Phong28Ng/drone-mini-xiao-esp32s3/docs/diagrams/1-so-do-khoi.png

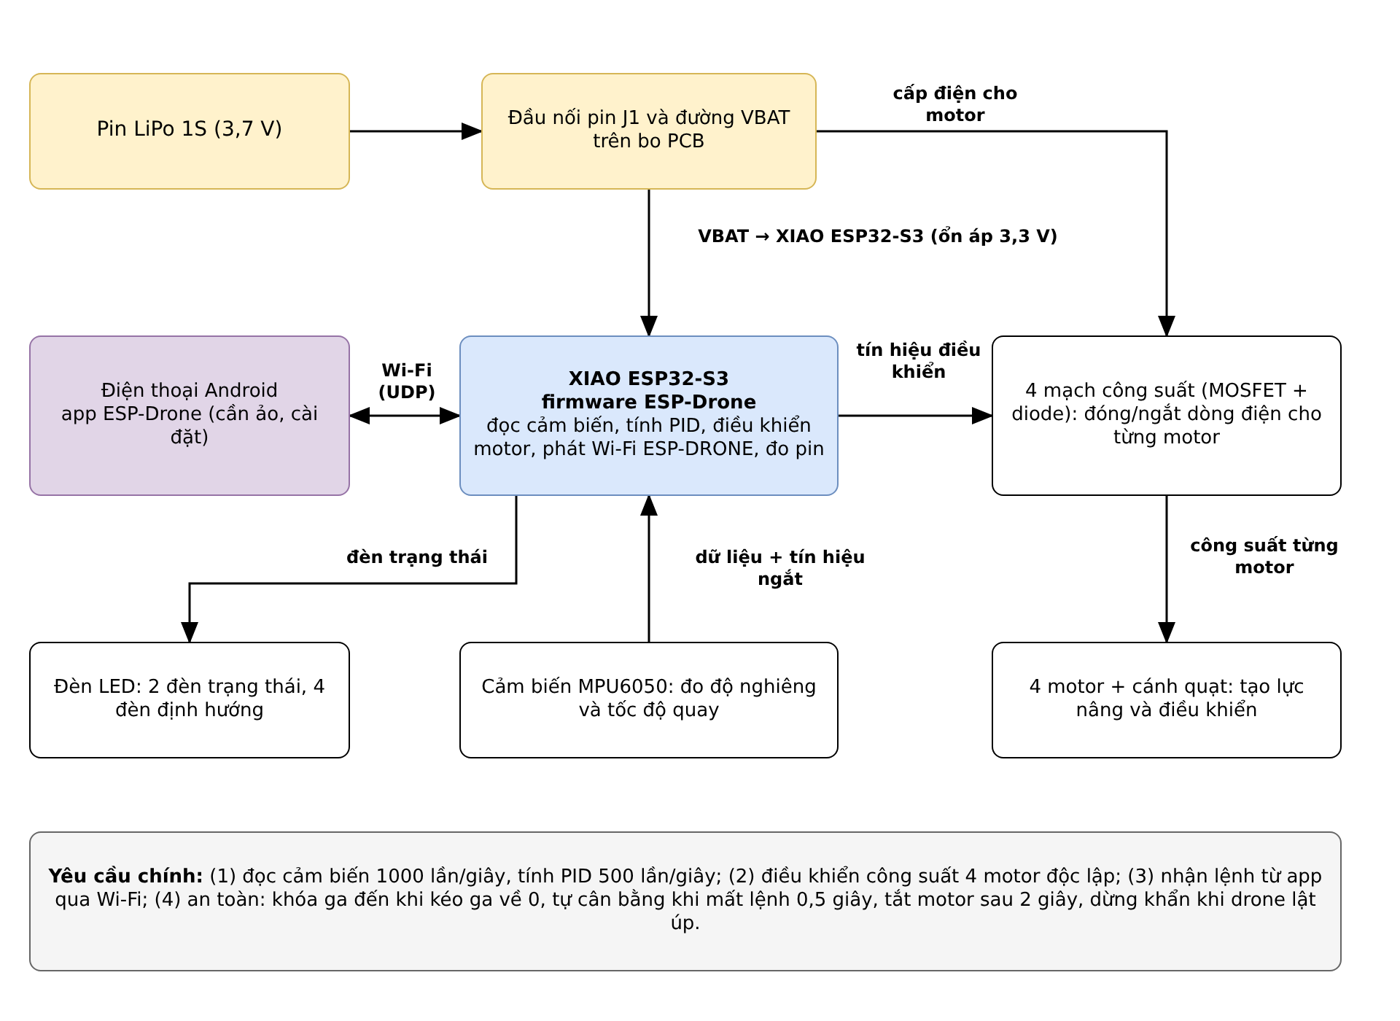
docs/diagrams/1-so-do-khoi.png
