Phong28Ng/drone-mini-xiao-esp32s3/docs/diagrams/2-so-do-dau-noi.png

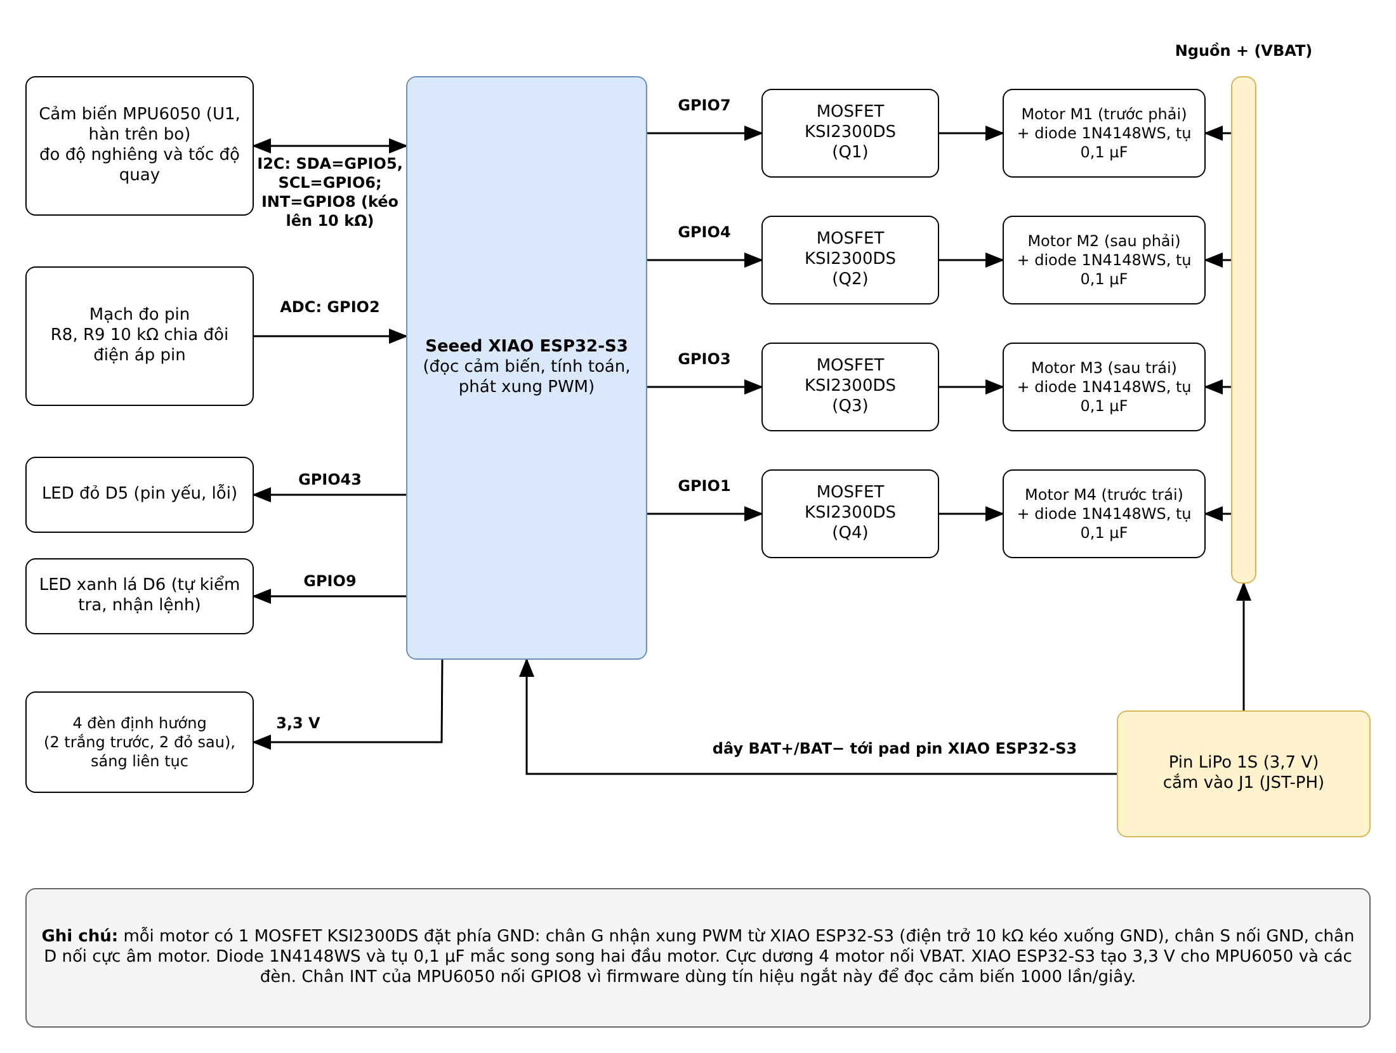
docs/diagrams/2-so-do-dau-noi.png
