Phong28Ng/drone-mini-xiao-esp32s3/docs/diagrams/3-luu-do-chuong-trinh-chinh.png

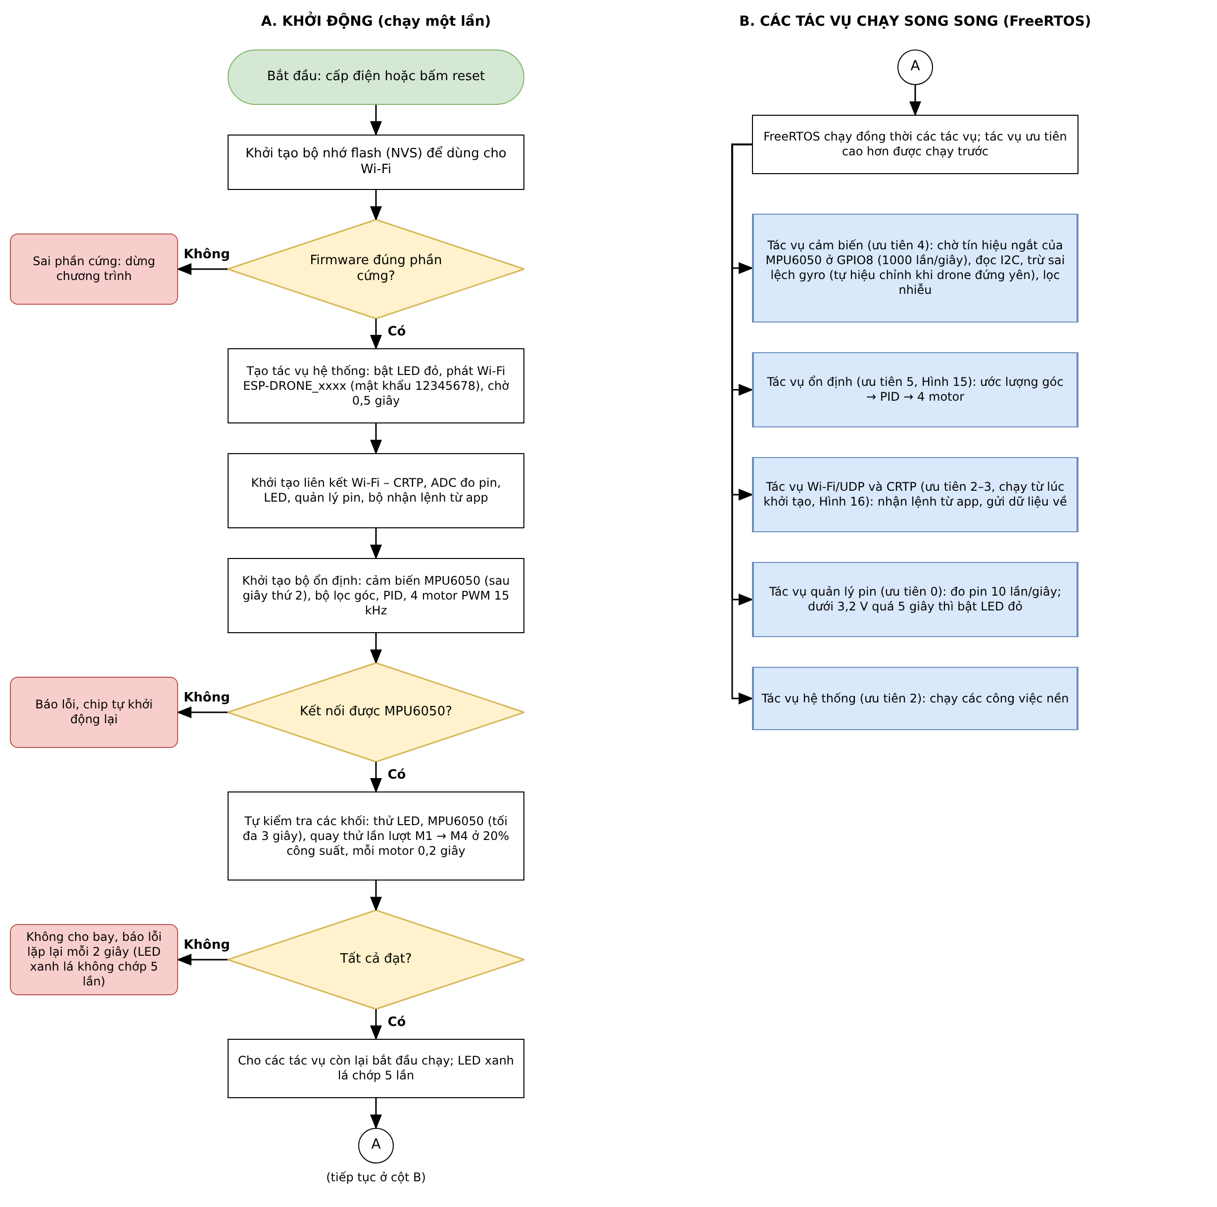
docs/diagrams/3-luu-do-chuong-trinh-chinh.png
