Phong28Ng/drone-mini-xiao-esp32s3/docs/diagrams/4-vong-on-dinh.png

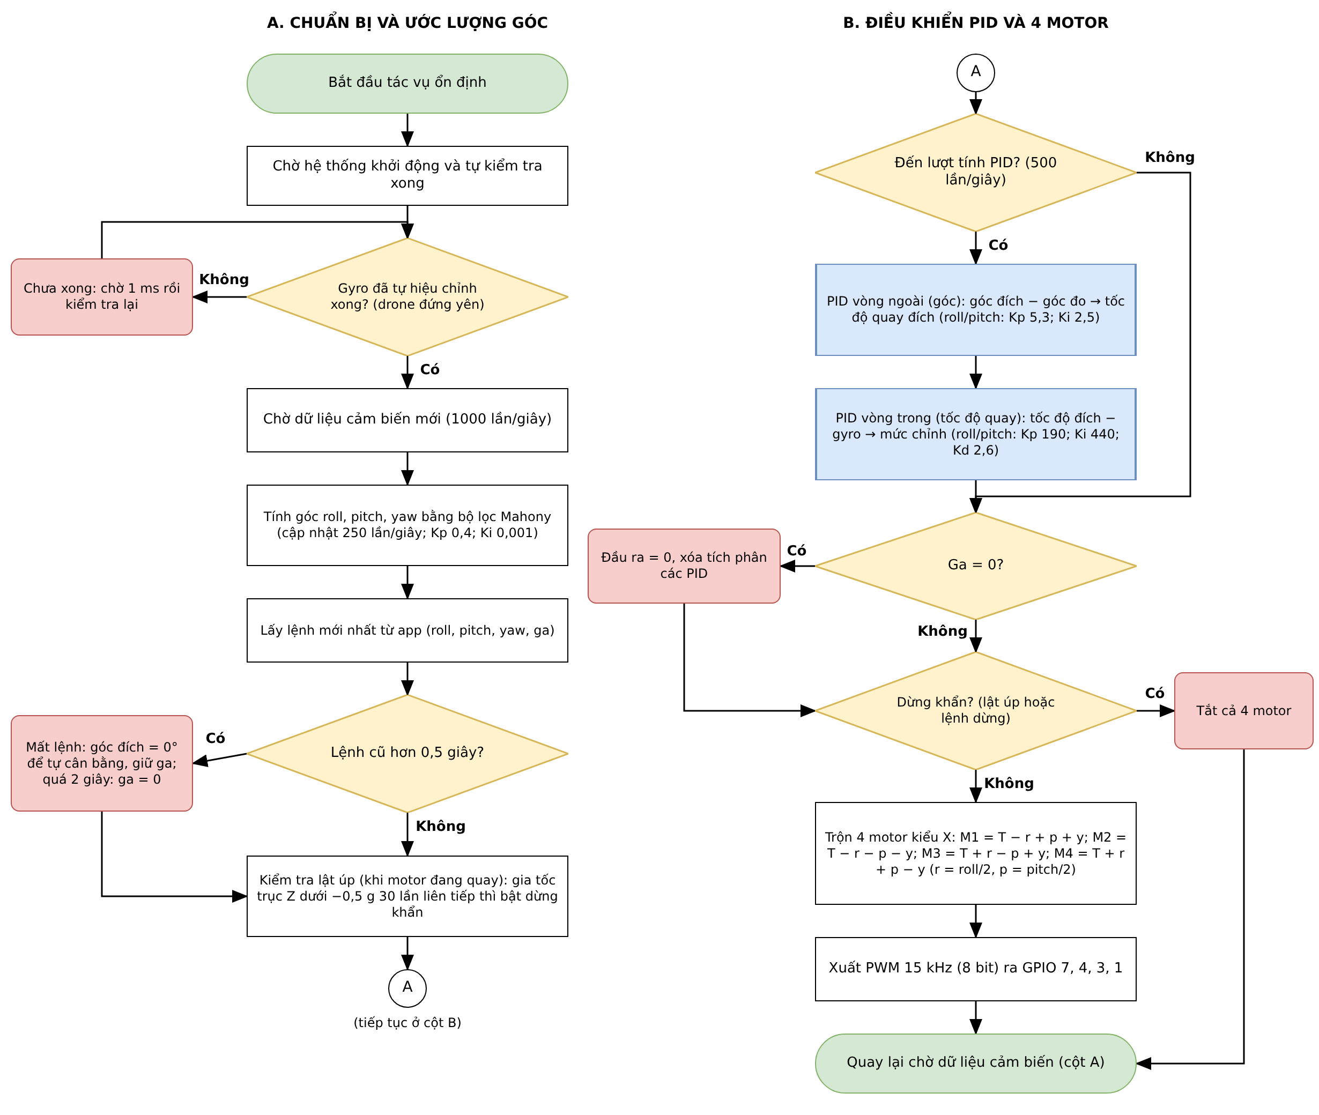
docs/diagrams/4-vong-on-dinh.png
