Phong28Ng/drone-mini-xiao-esp32s3/docs/diagrams/5-giao-tiep-app-drone.png

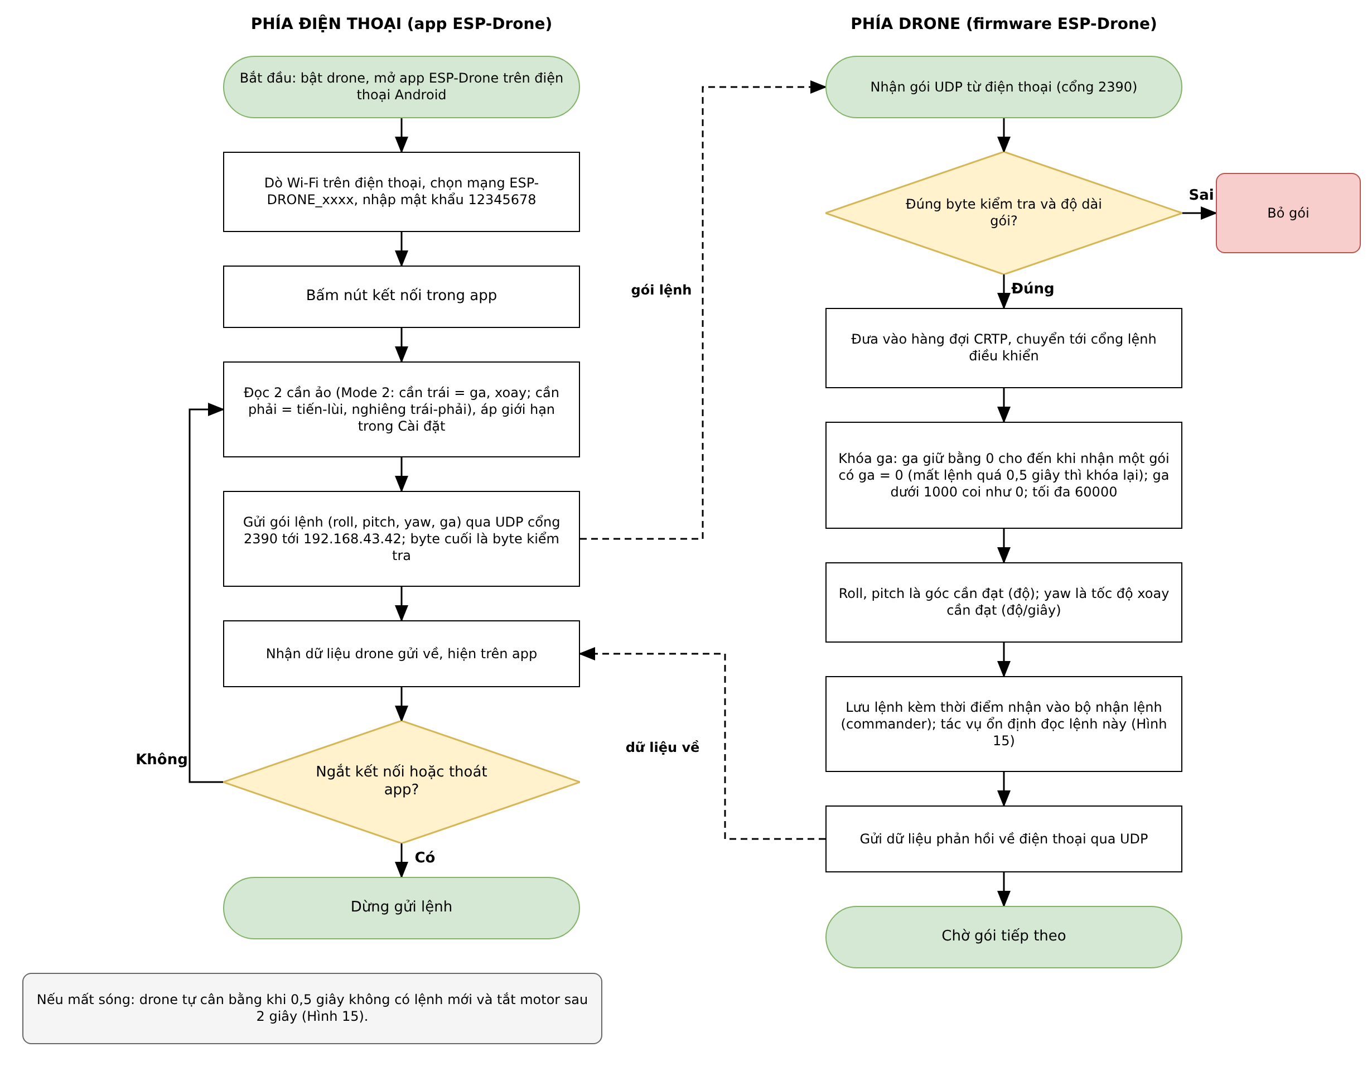
docs/diagrams/5-giao-tiep-app-drone.png
