Phong28Ng/drone-mini-xiao-esp32s3/docs/images/bo-mach-sau-gia-cong.png

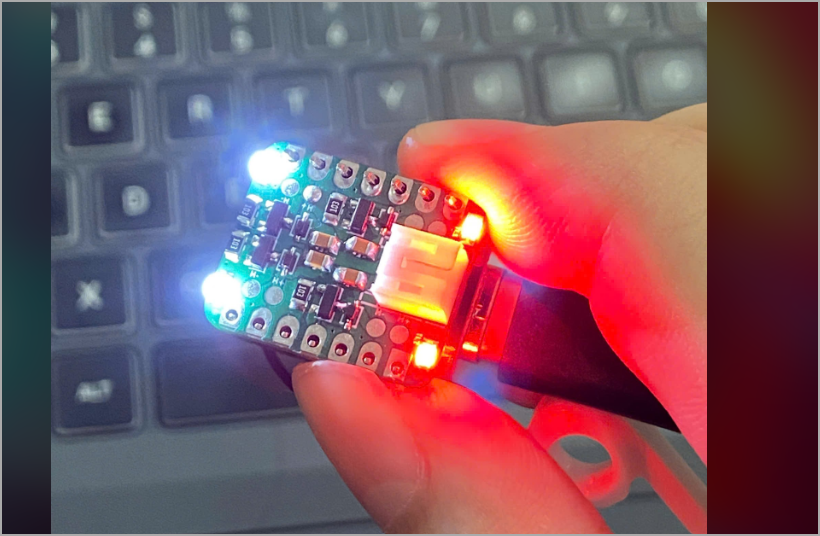
docs/images/bo-mach-sau-gia-cong.png
