Phong28Ng/drone-mini-xiao-esp32s3/docs/images/xiao-esp32-s3-hong-chan.png

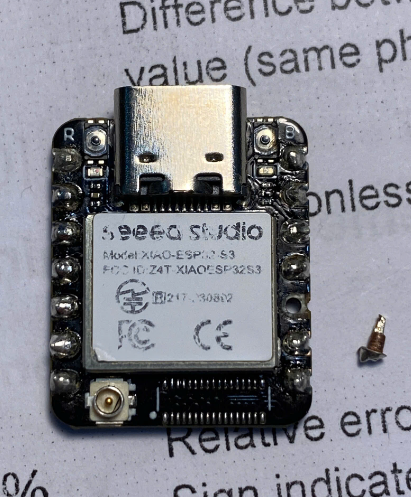
docs/images/xiao-esp32-s3-hong-chan.png
