Phong28Ng/drone-mini-xiao-esp32s3/frame/khung-3d-solidworks.png

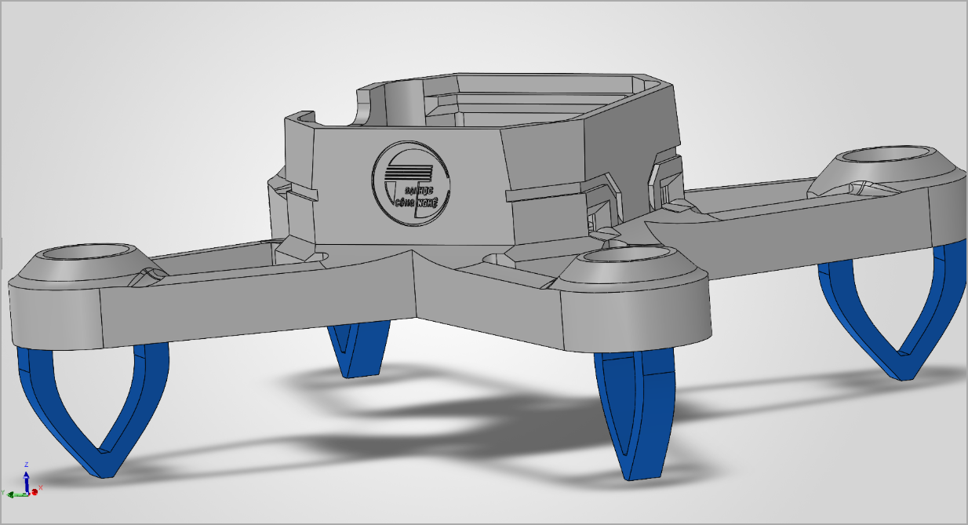
frame/khung-3d-solidworks.png
