Phong28Ng/drone-mini-xiao-esp32s3/hardware/BOM.xlsx

Ký hiệu tham chiếu | Số lượng | Giá trị / mô tả | Dấu chân PCB (Footprint) | Mã nhà sản xuất (MPN) | Công nghệ lắp ráp
R10, R11 | 2 | 200 | 0805 (2012 metric) | 0805W8F2000T5E | SMT
D1, D2, D3, D4 | 4 | 1N4148WS | SOD-323 | 1N4148WS-7-F | SMT
C6, C7 | 2 | 0.01uF | 0805 (2012 metric) | CC0805KRX7R9BB103 | SMT
C1, C2, C3, C4, C5, C8 | 6 | 0.1uF | 0805 (2012 metric) | CL21B104KBCNNNC | SMT
R12, R13 | 2 | 100 | 0805 (2012 metric) | CRCW0805100RFKEA | SMT
R1, R2, R3, R4, R5, R6, R7, R8, R9 | 9 | 10k | 0805 (2012 metric) | FRC0805F1002TS | SMT
Q1, Q2, Q3, Q4 | 4 | KSI2300DS | SOT-23 | KSI2300DS-T1-GE3 | SMT
U1 | 1 | MPU-6050 | QFN-24 4x4mm P0.5mm | MPU-6050 | SMT
D6 | 1 | Xanh lá | 0805 (2012 metric) | ORH-G35A | SMT
R14, R15 | 2 | 150 | 0805 (2012 metric) | RMS10FT1500 | SMT
J1 | 1 | JST-PH 1S LiPo | JST-PH 2pin P2.00mm right-angle THT | S2B-PH-K-S(LF)(SN) | THT
D5, TL1, TL2 | 3 | Đỏ | 0805 (2012 metric) | TZ-P2-0805RTCS2-0.8T | SMT
HL1, HL2 | 2 | Trắng | 0805 (2012 metric) | TZ-P2-0805WYCS2-0.8T | SMT
Tổng cộng | 39
