Phong28Ng/drone-mini-xiao-esp32s3/hardware/kicad/3dmodels/SOT-23.step

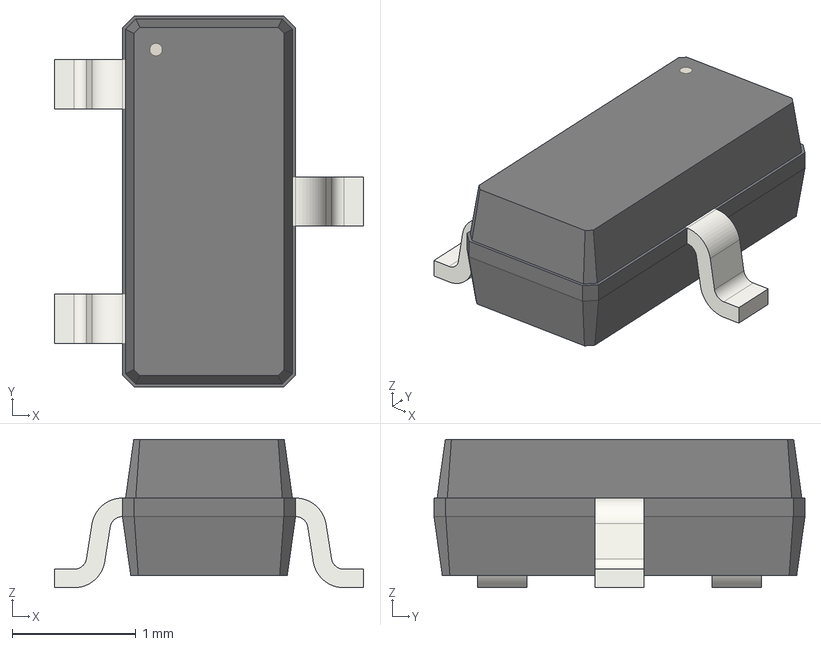
[picture p10: CAD file, 2026-11-12]
hardware/kicad/3dmodels/SOT-23.step
2.50 x 3.00 x 1.20 mm
