Phong28Ng/drone-mini-xiao-esp32s3/hardware/kicad/3dmodels/ESP-FLY-header-1x07-đã-cắt-ngắn.step

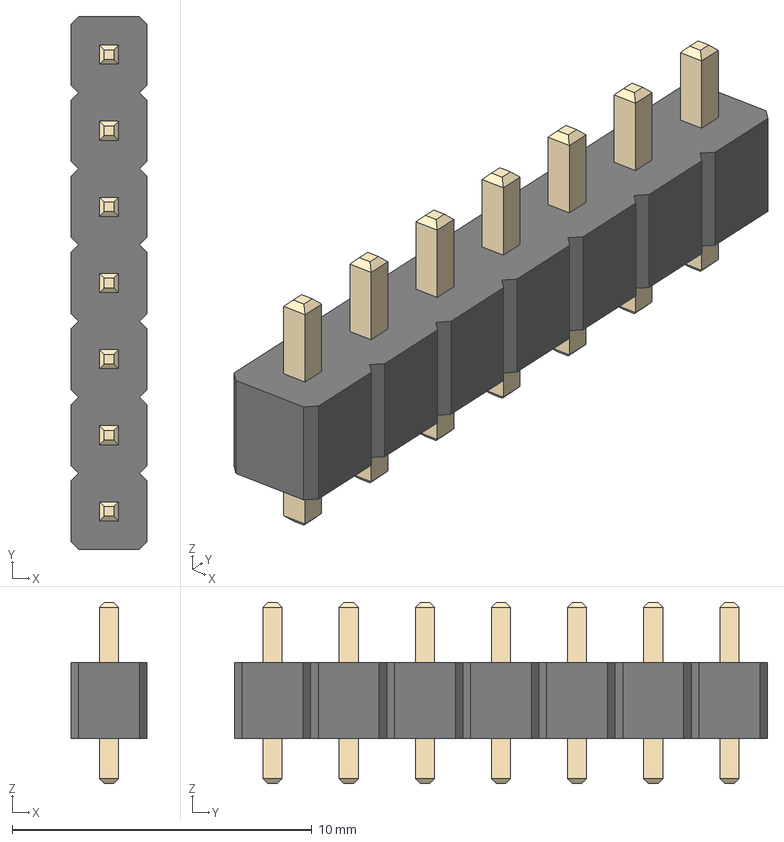
[picture p11: CAD file, 2026-11-12]
hardware/kicad/3dmodels/ESP-FLY-header-1x07-đã-cắt-ngắn.step
2.54 x 17.8 x 6.04 mm
