Phong28Ng/drone-mini-xiao-esp32s3/hardware/kicad/3dmodels/JST_PH_S2B-PH-K_1x02_P2.00mm_Horizontal.step

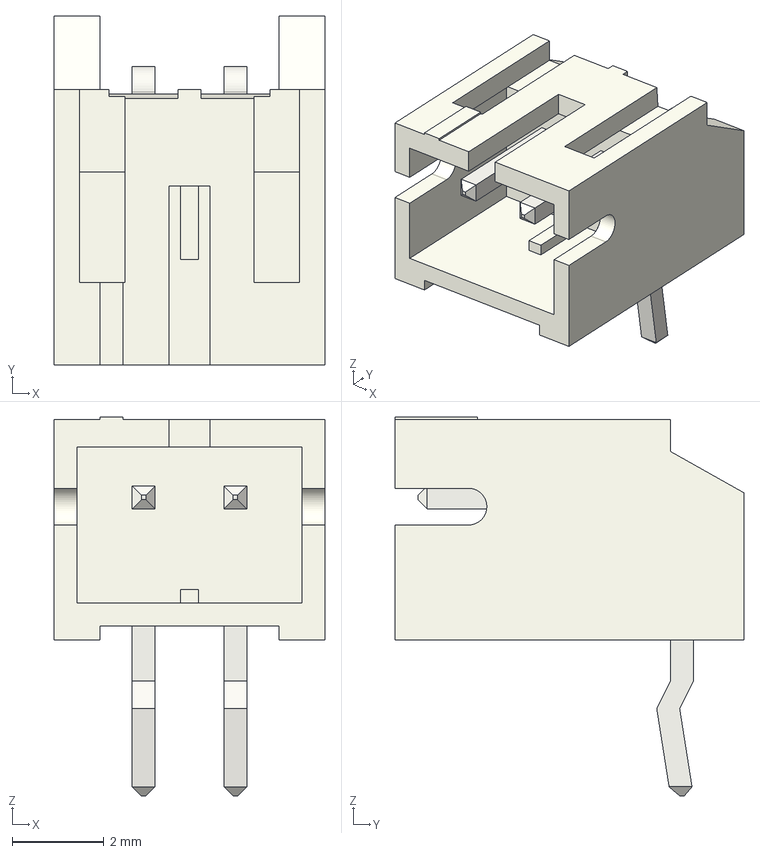
[picture p13: CAD file, 2026-11-12]
hardware/kicad/3dmodels/JST_PH_S2B-PH-K_1x02_P2.00mm_Horizontal.step
5.90 x 7.60 x 8.25 mm
