Phong28Ng/drone-mini-xiao-esp32s3/hardware/kicad/3dmodels/LED_0805_2012Metric.step

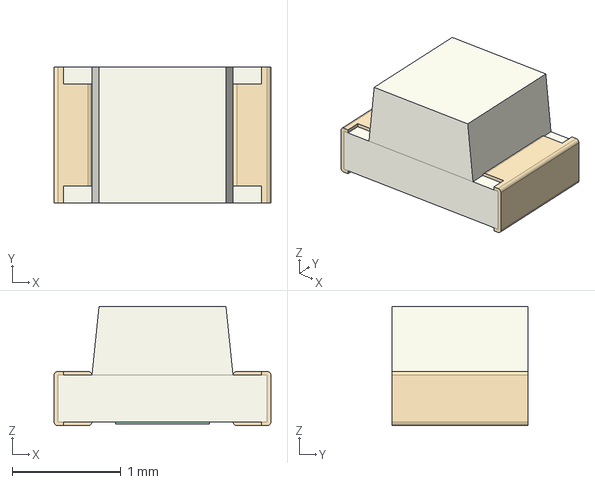
[picture p14: CAD file, 2026-11-12]
hardware/kicad/3dmodels/LED_0805_2012Metric.step
2.00 x 1.25 x 1.10 mm
