Phong28Ng/drone-mini-xiao-esp32s3/hardware/kicad/3dmodels/QFN-24_4x4mm_P0.5mm.step

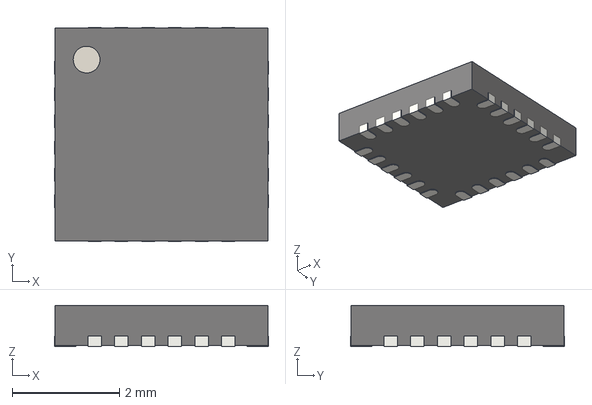
[picture p16: CAD file, 2026-11-12]
hardware/kicad/3dmodels/QFN-24_4x4mm_P0.5mm.step
4.00 x 4.00 x 0.77 mm
