Phong28Ng/drone-mini-xiao-esp32s3/hardware/kicad/3dmodels/D_SOD-323.step

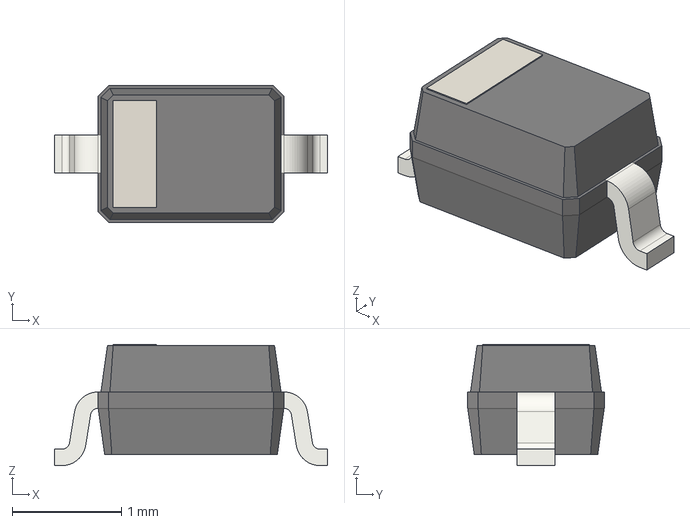
[picture p18: CAD file, 2026-11-12]
hardware/kicad/3dmodels/D_SOD-323.step
2.50 x 1.25 x 1.11 mm
