Phong28Ng/drone-mini-xiao-esp32s3/hardware/ban-ve-lap-rap.pdf

# ESP-FLY - Bản vẽ lắp linh kiện PCB

## Mặt trên (Top) - nhìn từ trên

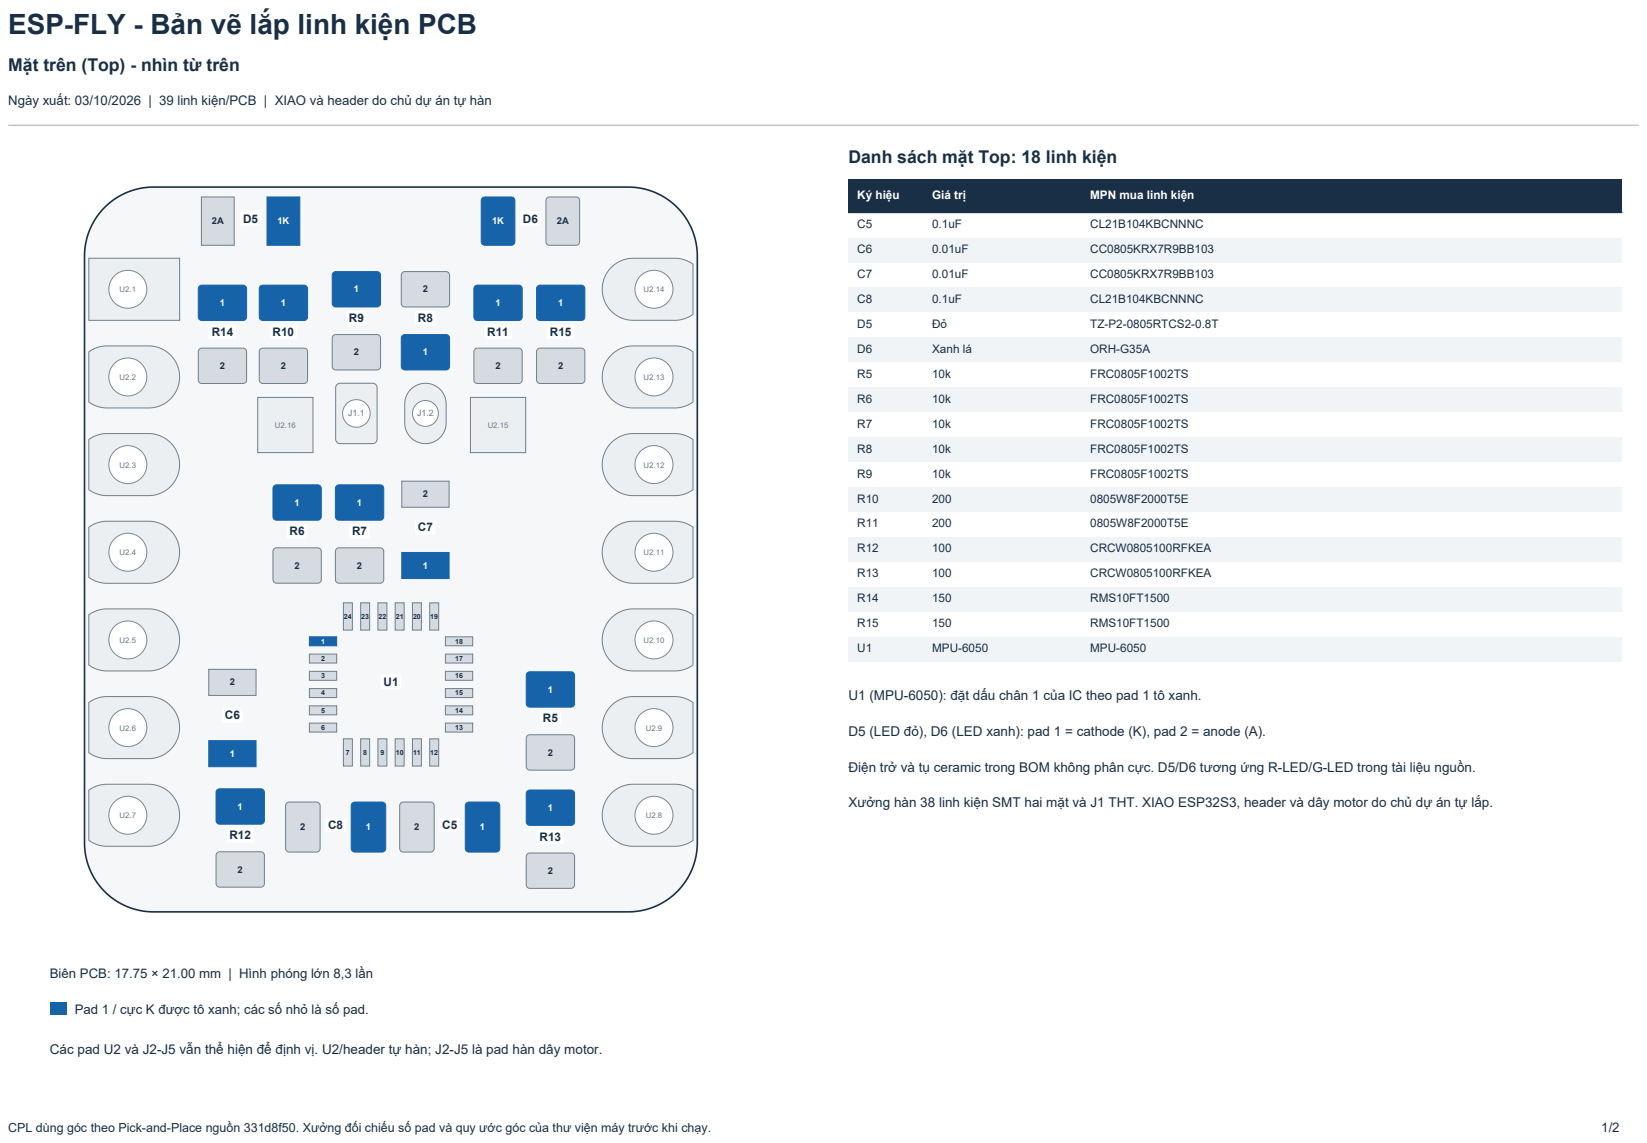
[picture p19: page 1]

Ngày xuất: 03/10/2026 | 39 linh kiện/PCB | XIAO và header do chủ dự án tự hàn

Danh sách mặt Top: 18 linh kiện

U1 (MPU-6050): đặt dấu chân 1 của IC theo pad 1 tô xanh.

D5 (LED đỏ), D6 (LED xanh): pad 1 = cathode (K), pad 2 = anode (A).

Điện trở và tụ ceramic trong BOM không phân cực. D5/D6 tương ứng R-LED/G-LED trong tài liệu nguồn.

Xưởng hàn 38 linh kiện SMT hai mặt và J1 THT. XIAO ESP32S3, header và dây motor do chủ dự án tự lắp.

Biên PCB: 17.75 × 21.00 mm | Hình phóng lớn 8,3 lần

Pad 1 / cực K được tô xanh; các số nhỏ là số pad.

Các pad U2 và J2-J5 vẫn thể hiện để định vị. U2/header tự hàn; J2-J5 là pad hàn dây motor.

# ESP-FLY - Bản vẽ lắp linh kiện PCB

## Mặt dưới (Bottom) - nhìn trực tiếp từ dưới

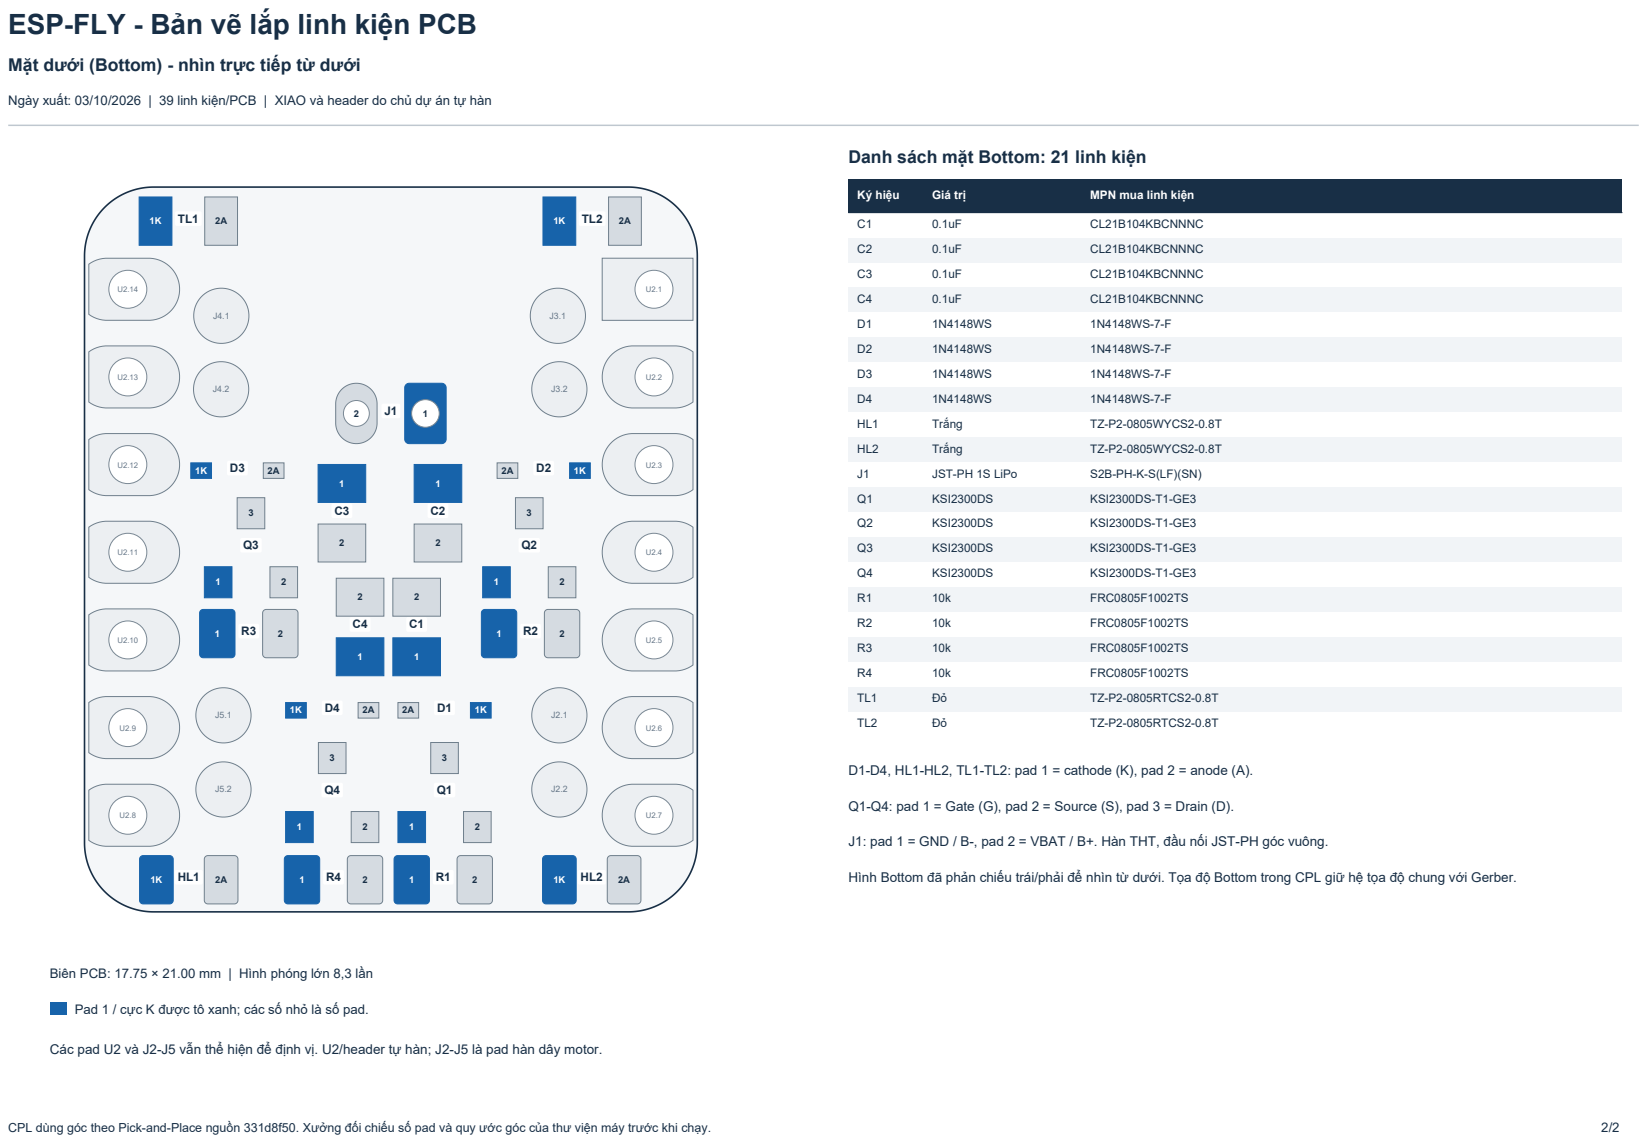
[picture p20: page 2]
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

Danh sách mặt Bottom: 21 linh kiện

D1-D4, HL1-HL2, TL1-TL2: pad 1 = cathode (K), pad 2 = anode (A).

Q1-Q4: pad 1 = Gate (G), pad 2 = Source (S), pad 3 = Drain (D).

J1: pad 1 = GND / B-, pad 2 = VBAT / B+. Hàn THT, đầu nối JST-PH góc vuông.

Hình Bottom đã phản chiếu trái/phải để nhìn từ dưới. Tọa độ Bottom trong CPL giữ hệ tọa độ chung với Gerber.

Biên PCB: 17.75 × 21.00 mm | Hình phóng lớn 8,3 lần

Pad 1 / cực K được tô xanh; các số nhỏ là số pad.

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
