Phong28Ng/drone-mini-xiao-esp32s3/hardware/kicad/ESP-FLY.kicad_pcb

## KiCad design hardware/kicad/ESP-FLY.kicad_pcb (2026-11-12)

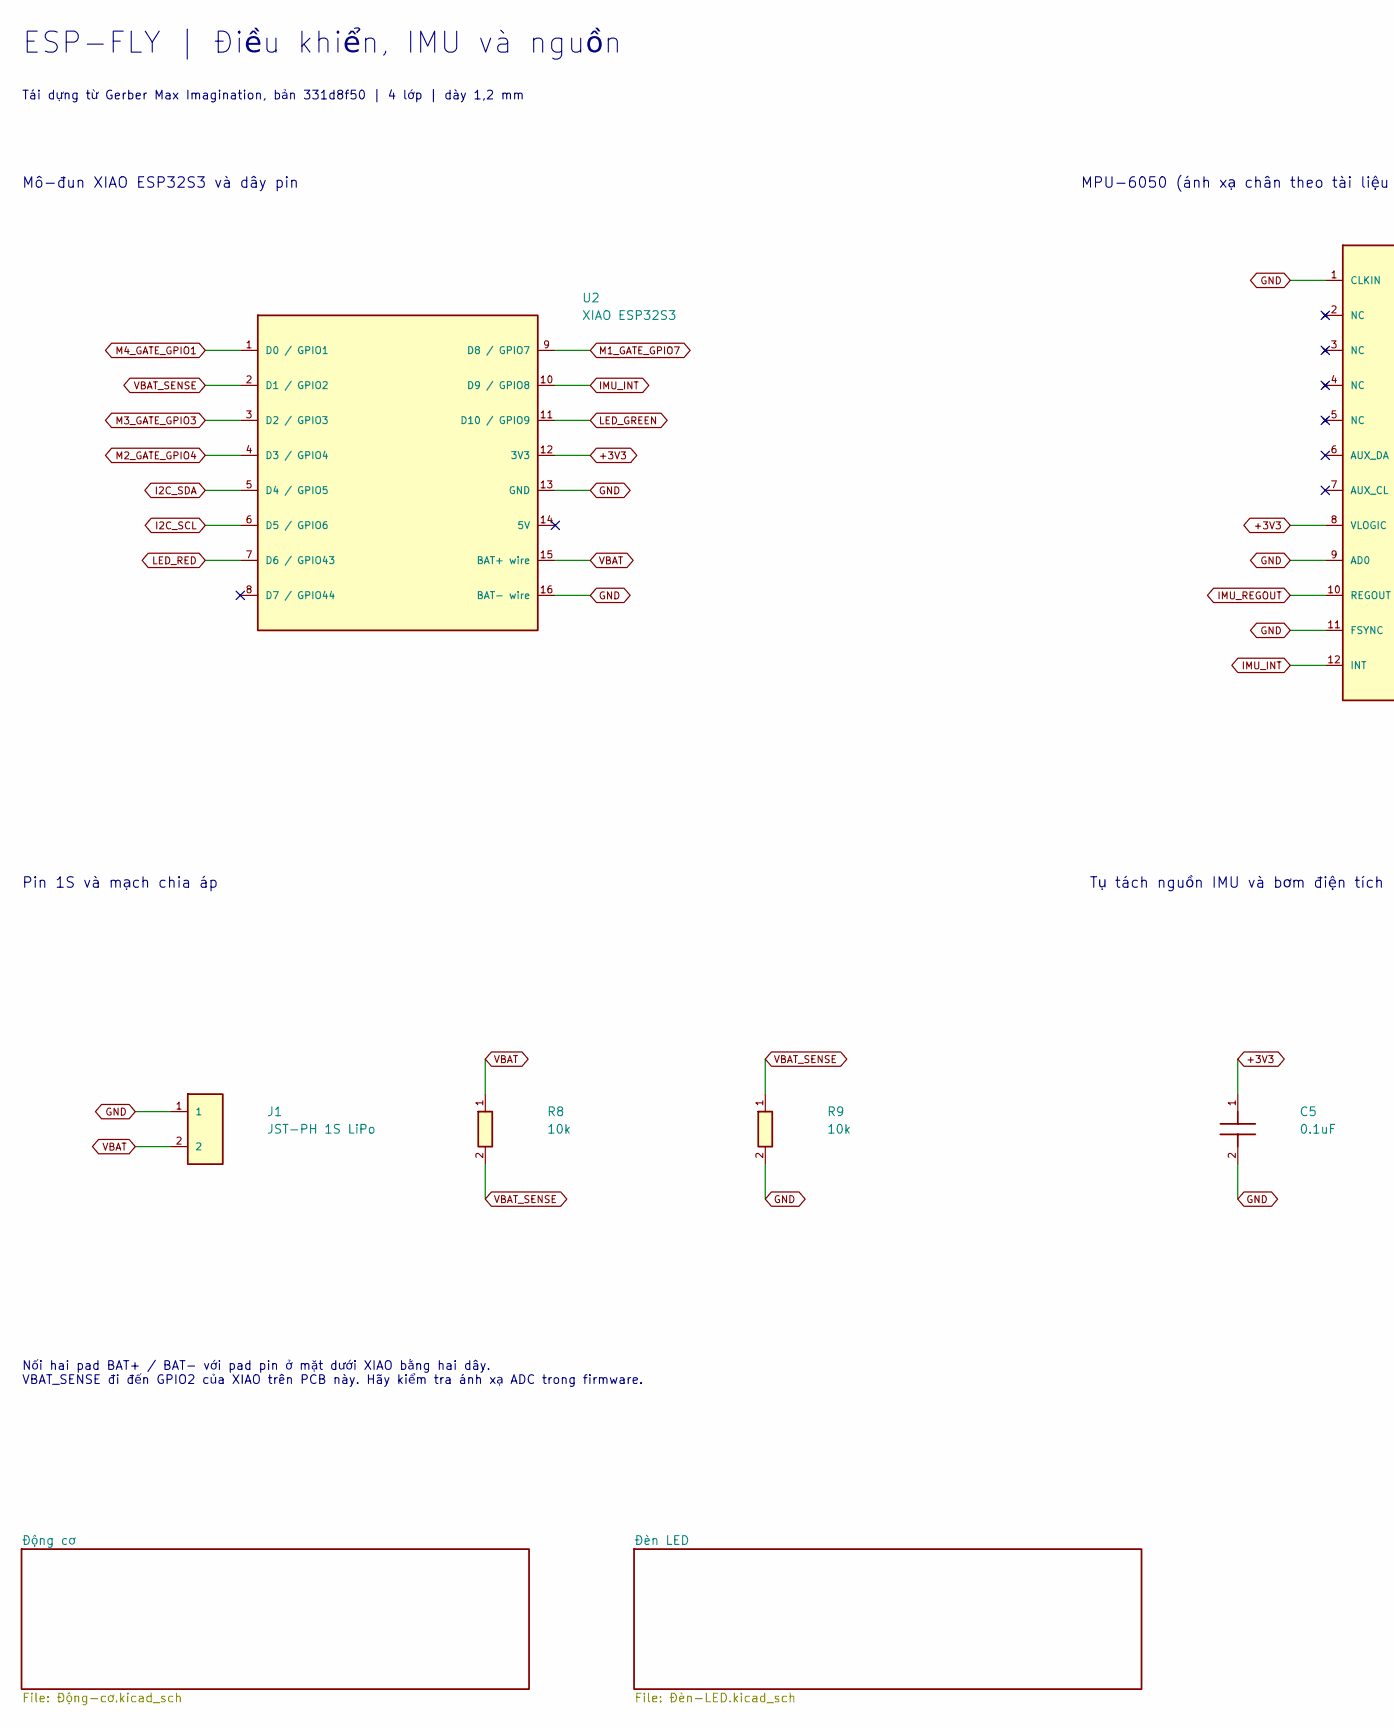
[picture p24: schematic ESP-FLY.kicad_sch, ESP-FLY | Điều khiển, IMU và nguồn, part in row 1, column 1]

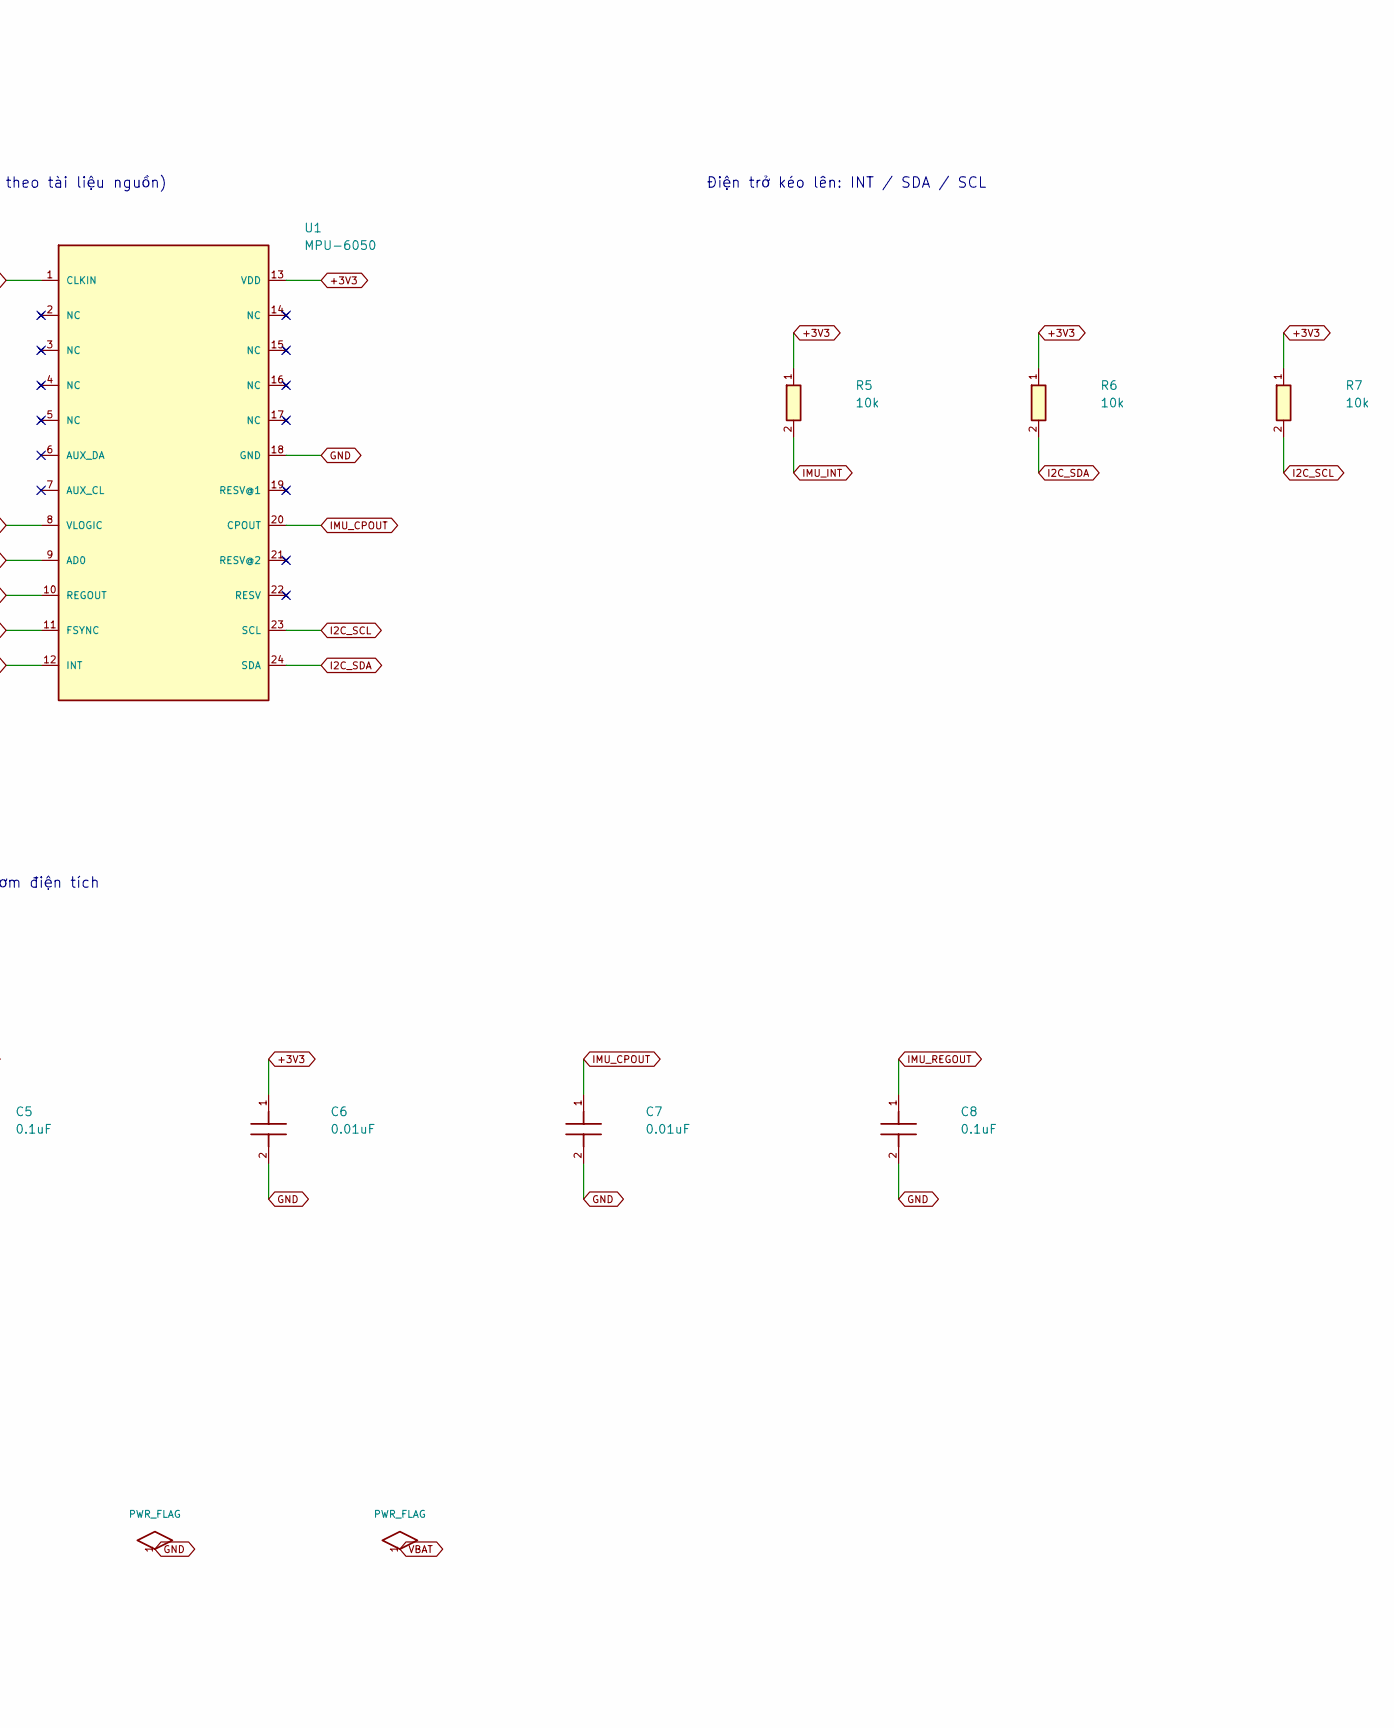
[picture p25: schematic ESP-FLY.kicad_sch, ESP-FLY | Điều khiển, IMU và nguồn, part in row 1, column 2]

Parts:
C5: 0.1uF; C5; ManufacturerPartNumber CL21B104KBCNNNC
C6: 0.01uF; C6; ManufacturerPartNumber CC0805KRX7R9BB103
C7: 0.01uF; C7; ManufacturerPartNumber CC0805KRX7R9BB103
C8: 0.1uF; C8; ManufacturerPartNumber CL21B104KBCNNNC
J1: JST-PH 1S LiPo; J1; ManufacturerPartNumber S2B-PH-K-S(LF)(SN)
R5: 10k; R5; ManufacturerPartNumber FRC0805F1002TS
R6: 10k; R6; ManufacturerPartNumber FRC0805F1002TS
R7: 10k; R7; ManufacturerPartNumber FRC0805F1002TS
R8: 10k; R8; ManufacturerPartNumber FRC0805F1002TS
R9: 10k; R9; ManufacturerPartNumber FRC0805F1002TS
U1: MPU-6050; U1; ManufacturerPartNumber MPU-6050
U2: XIAO ESP32S3; U2

Connections:
+3V3: C5.1, C6.1, R5.1, R6.1, R7.1, U1.8 (VLOGIC), U1.13 (VDD), U2.12 (3V3); also elsewhere on the board
GND: C5.2, C6.2, C7.2, C8.2, J1.1, R9.2, U1.1 (CLKIN), U1.9 (AD0), U1.11 (FSYNC), U1.18 (GND), U2.13 (GND), U2.16 (BAT- wire); also elsewhere on the board
I2C_SCL: R7.2, U1.23 (SCL), U2.6 (D5 / GPIO6)
I2C_SDA: R6.2, U1.24 (SDA), U2.5 (D4 / GPIO5)
IMU_CPOUT: C7.1, U1.20 (CPOUT)
IMU_INT: R5.2, U1.12 (INT), U2.10 (D9 / GPIO8)
IMU_REGOUT: C8.1, U1.10 (REGOUT)
LED_GREEN: U2.11 (D10 / GPIO9); also elsewhere on the board
LED_RED: U2.7 (D6 / GPIO43); also elsewhere on the board
M1_GATE_GPIO7: U2.9 (D8 / GPIO7); also elsewhere on the board
M2_GATE_GPIO4: U2.4 (D3 / GPIO4); also elsewhere on the board
M3_GATE_GPIO3: U2.3 (D2 / GPIO3); also elsewhere on the board
M4_GATE_GPIO1: U2.1 (D0 / GPIO1); also elsewhere on the board
VBAT: J1.2, R8.1, U2.15 (BAT+ wire); also elsewhere on the board
VBAT_SENSE: R8.2, R9.1, U2.2 (D1 / GPIO2)

Notes on the sheet:
ESP-FLY | Điều khiển, IMU và nguồn
Tái dựng từ Gerber Max Imagination, bản 331d8f50 | 4 lớp | dày 1,2 mm
Mô-đun XIAO ESP32S3 và dây pin
MPU-6050 (ánh xạ chân theo tài liệu nguồn)
Điện trở kéo lên: INT / SDA / SCL
Pin 1S và mạch chia áp
Tụ tách nguồn IMU và bơm điện tích
Nối hai pad BAT+ / BAT- với pad pin ở mặt dưới XIAO bằng hai dây. VBAT_SENSE đi đến GPIO2 của XIAO trên PCB này. Hãy kiểm tra ánh xạ ADC trong firmware.

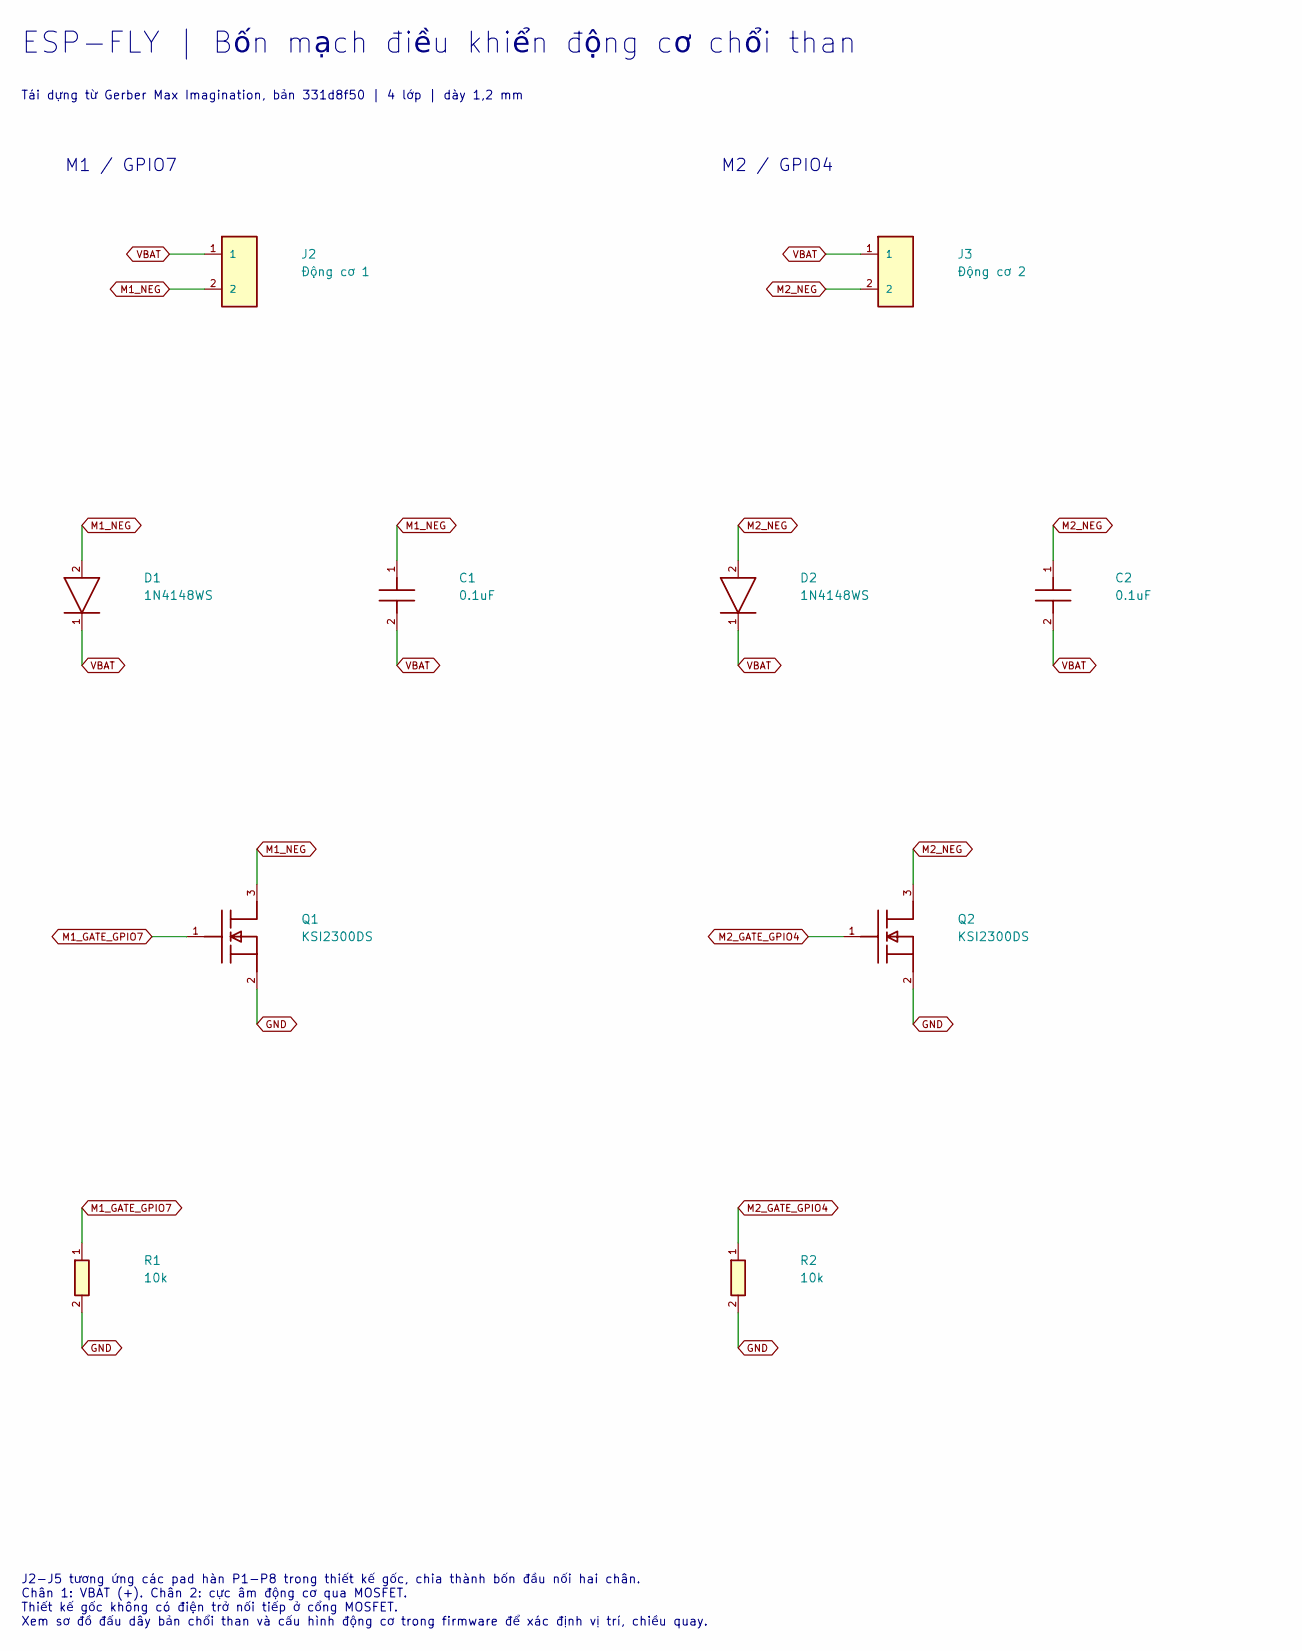
[picture p26: schematic Động-cơ.kicad_sch, ESP-FLY | Bốn mạch điều khiển động cơ chổi than, part in row 1, column 1]

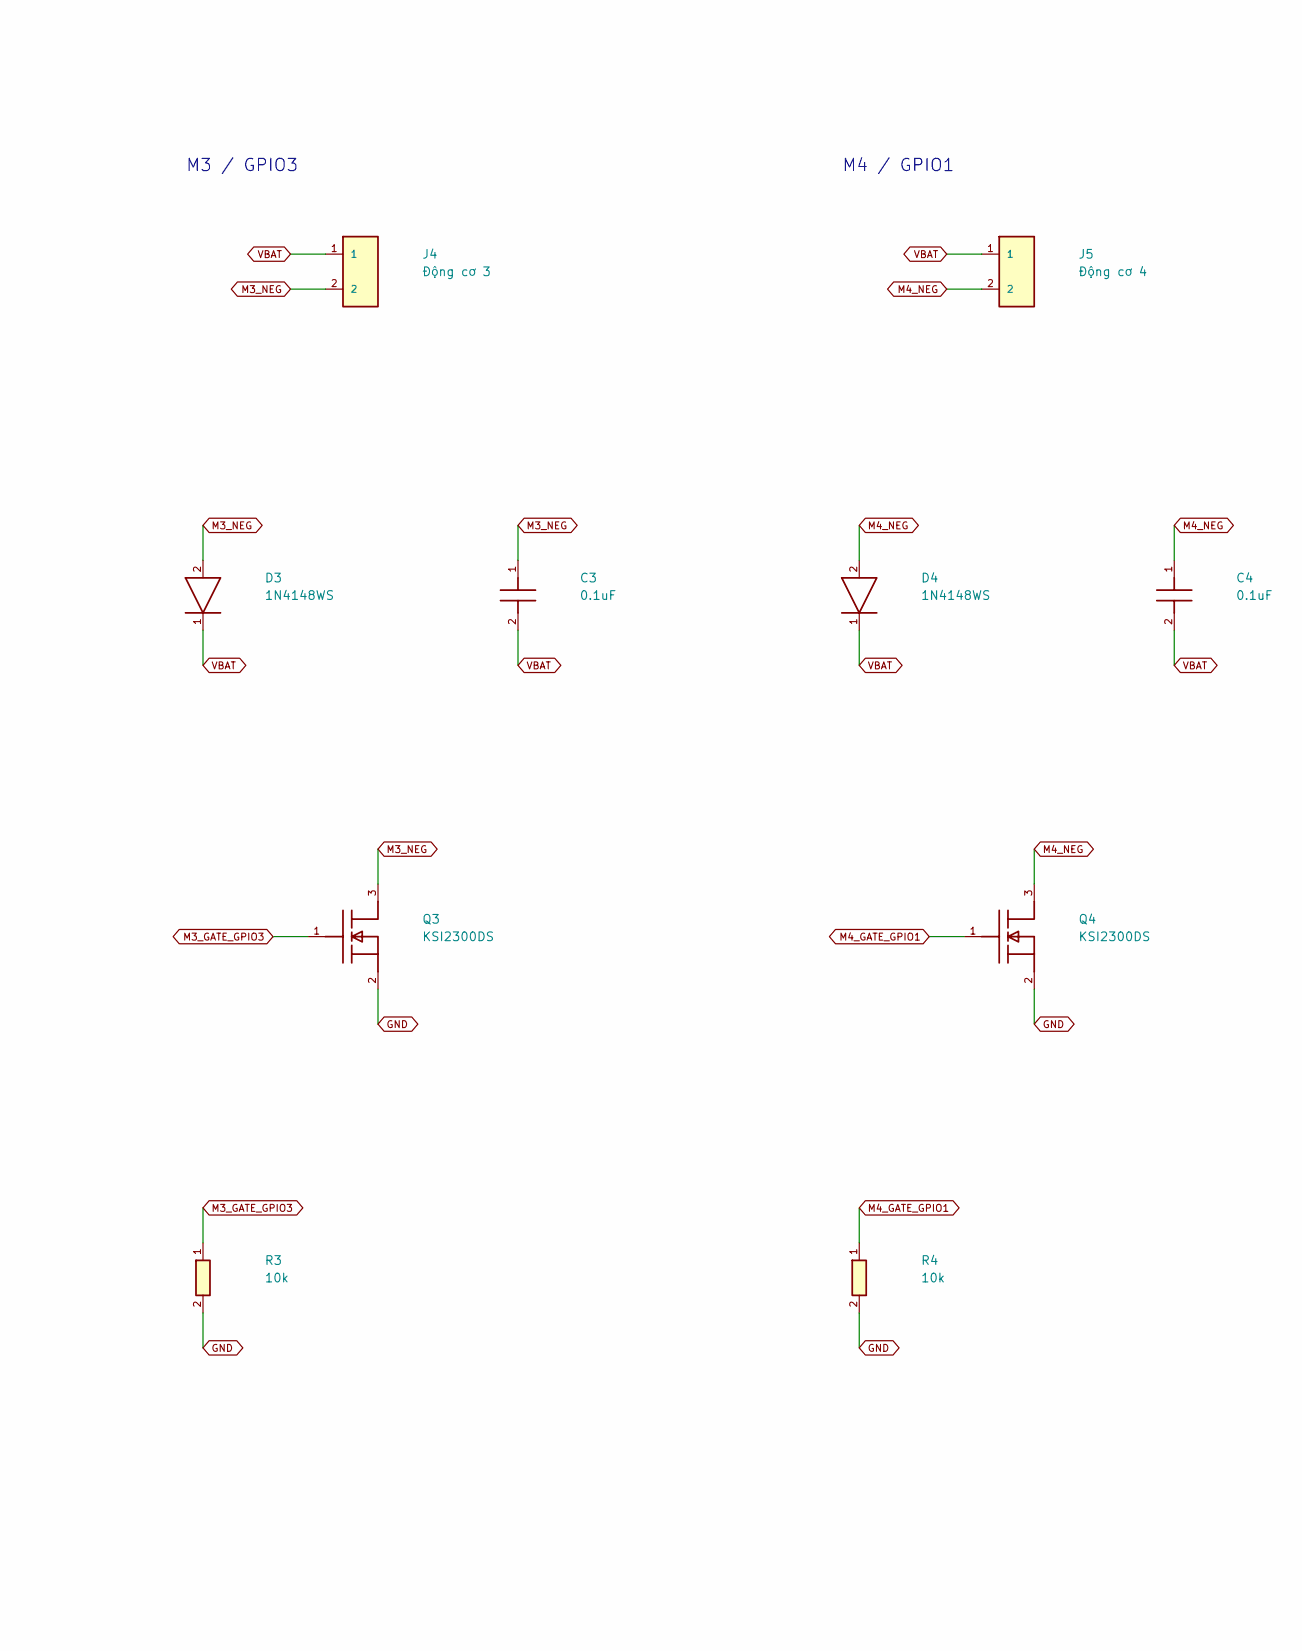
[picture p27: schematic Động-cơ.kicad_sch, ESP-FLY | Bốn mạch điều khiển động cơ chổi than, part in row 1, column 2]

Parts:
C1: 0.1uF; C1; ManufacturerPartNumber CL21B104KBCNNNC
C2: 0.1uF; C2; ManufacturerPartNumber CL21B104KBCNNNC
C3: 0.1uF; C3; ManufacturerPartNumber CL21B104KBCNNNC
C4: 0.1uF; C4; ManufacturerPartNumber CL21B104KBCNNNC
D1: 1N4148WS; D1; ManufacturerPartNumber 1N4148WS-7-F
D2: 1N4148WS; D2; ManufacturerPartNumber 1N4148WS-7-F
D3: 1N4148WS; D3; ManufacturerPartNumber 1N4148WS-7-F
D4: 1N4148WS; D4; ManufacturerPartNumber 1N4148WS-7-F
J2: Động cơ 1; J2
J3: Động cơ 2; J3
J4: Động cơ 3; J4
J5: Động cơ 4; J5
Q1: KSI2300DS; Q1; ManufacturerPartNumber KSI2300DS-T1-GE3
Q2: KSI2300DS; Q2; ManufacturerPartNumber KSI2300DS-T1-GE3
Q3: KSI2300DS; Q3; ManufacturerPartNumber KSI2300DS-T1-GE3
Q4: KSI2300DS; Q4; ManufacturerPartNumber KSI2300DS-T1-GE3
R1: 10k; R1; ManufacturerPartNumber FRC0805F1002TS
R2: 10k; R2; ManufacturerPartNumber FRC0805F1002TS
R3: 10k; R3; ManufacturerPartNumber FRC0805F1002TS
R4: 10k; R4; ManufacturerPartNumber FRC0805F1002TS

Connections:
GND: Q1.2 (S), Q2.2 (S), Q3.2 (S), Q4.2 (S), R1.2, R2.2, R3.2, R4.2; also elsewhere on the board
M1_GATE_GPIO7: Q1.1 (G), R1.1; also elsewhere on the board
M1_NEG: C1.1, D1.2 (A), J2.2, Q1.3 (D)
M2_GATE_GPIO4: Q2.1 (G), R2.1; also elsewhere on the board
M2_NEG: C2.1, D2.2 (A), J3.2, Q2.3 (D)
M3_GATE_GPIO3: Q3.1 (G), R3.1; also elsewhere on the board
M3_NEG: C3.1, D3.2 (A), J4.2, Q3.3 (D)
M4_GATE_GPIO1: Q4.1 (G), R4.1; also elsewhere on the board
M4_NEG: C4.1, D4.2 (A), J5.2, Q4.3 (D)
VBAT: C1.2, C2.2, C3.2, C4.2, D1.1 (K), D2.1 (K), D3.1 (K), D4.1 (K), J2.1, J3.1, J4.1, J5.1; also elsewhere on the board

Notes on the sheet:
ESP-FLY | Bốn mạch điều khiển động cơ chổi than
Tái dựng từ Gerber Max Imagination, bản 331d8f50 | 4 lớp | dày 1,2 mm
M1 / GPIO7
M2 / GPIO4
M3 / GPIO3
M4 / GPIO1
J2-J5 tương ứng các pad hàn P1-P8 trong thiết kế gốc, chia thành bốn đầu nối hai chân. Chân 1: VBAT (+). Chân 2: cực âm động cơ qua MOSFET. Thiết kế gốc không có điện trở nối tiếp ở cổng MOSFET. Xem sơ đồ đấu dây bản chổi than và cấu hình động cơ trong firmware để xác định vị trí, chiều quay.

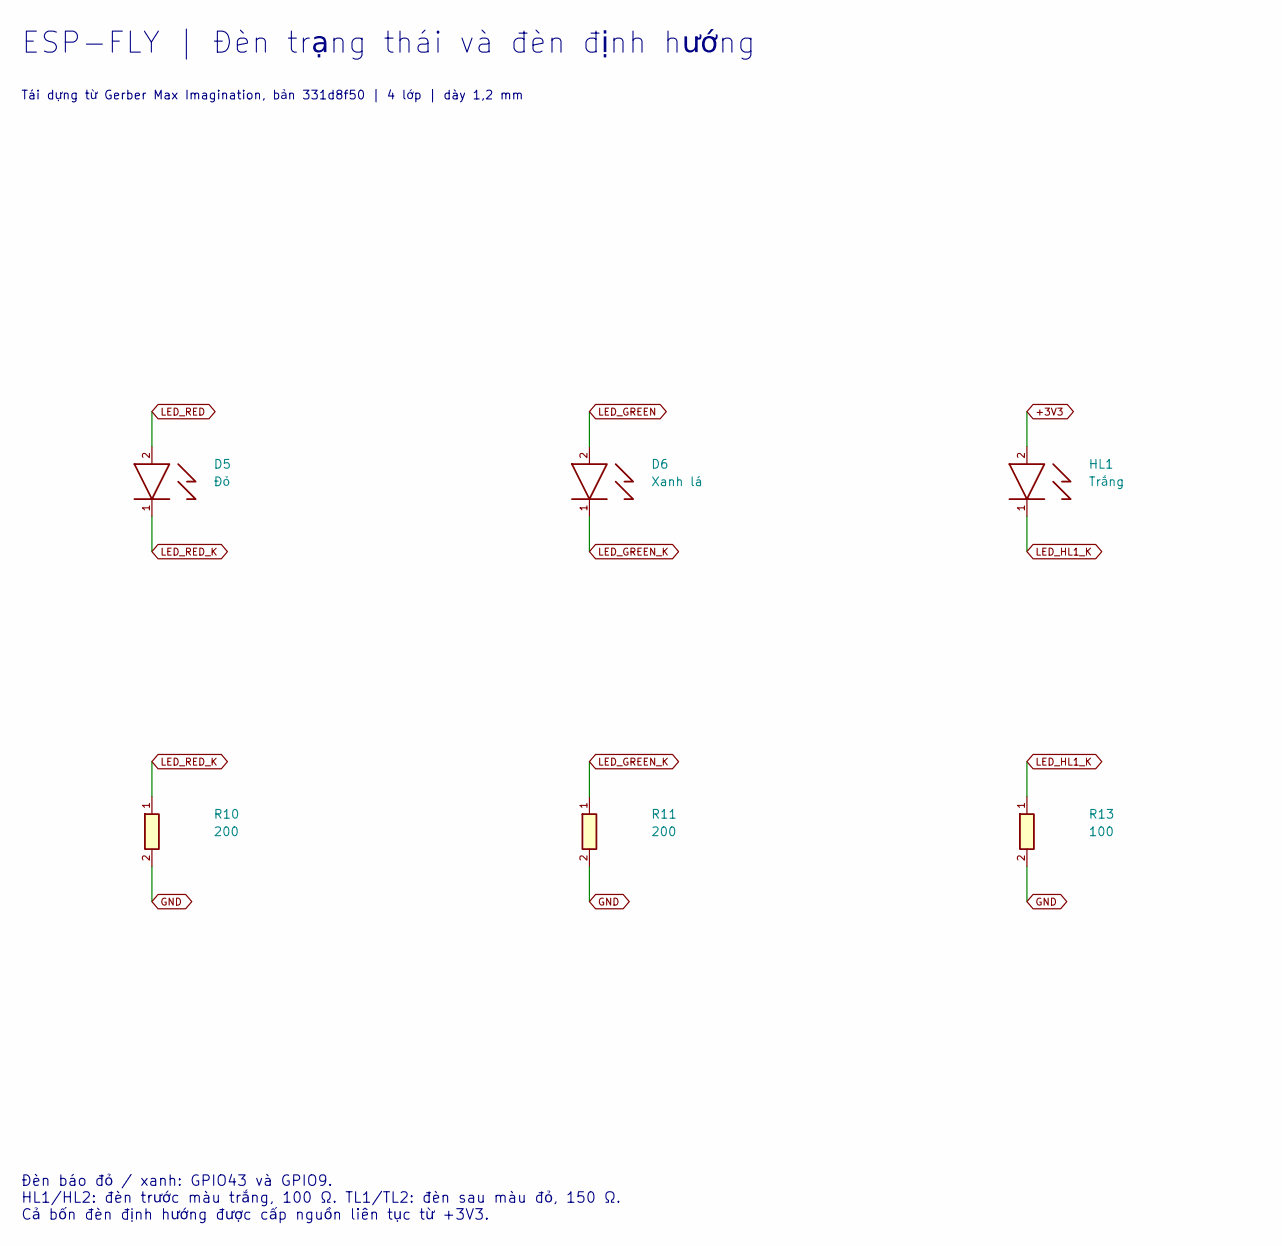
[picture p28: schematic Đèn-LED.kicad_sch, ESP-FLY | Đèn trạng thái và đèn định hướng, part in row 1, column 1]

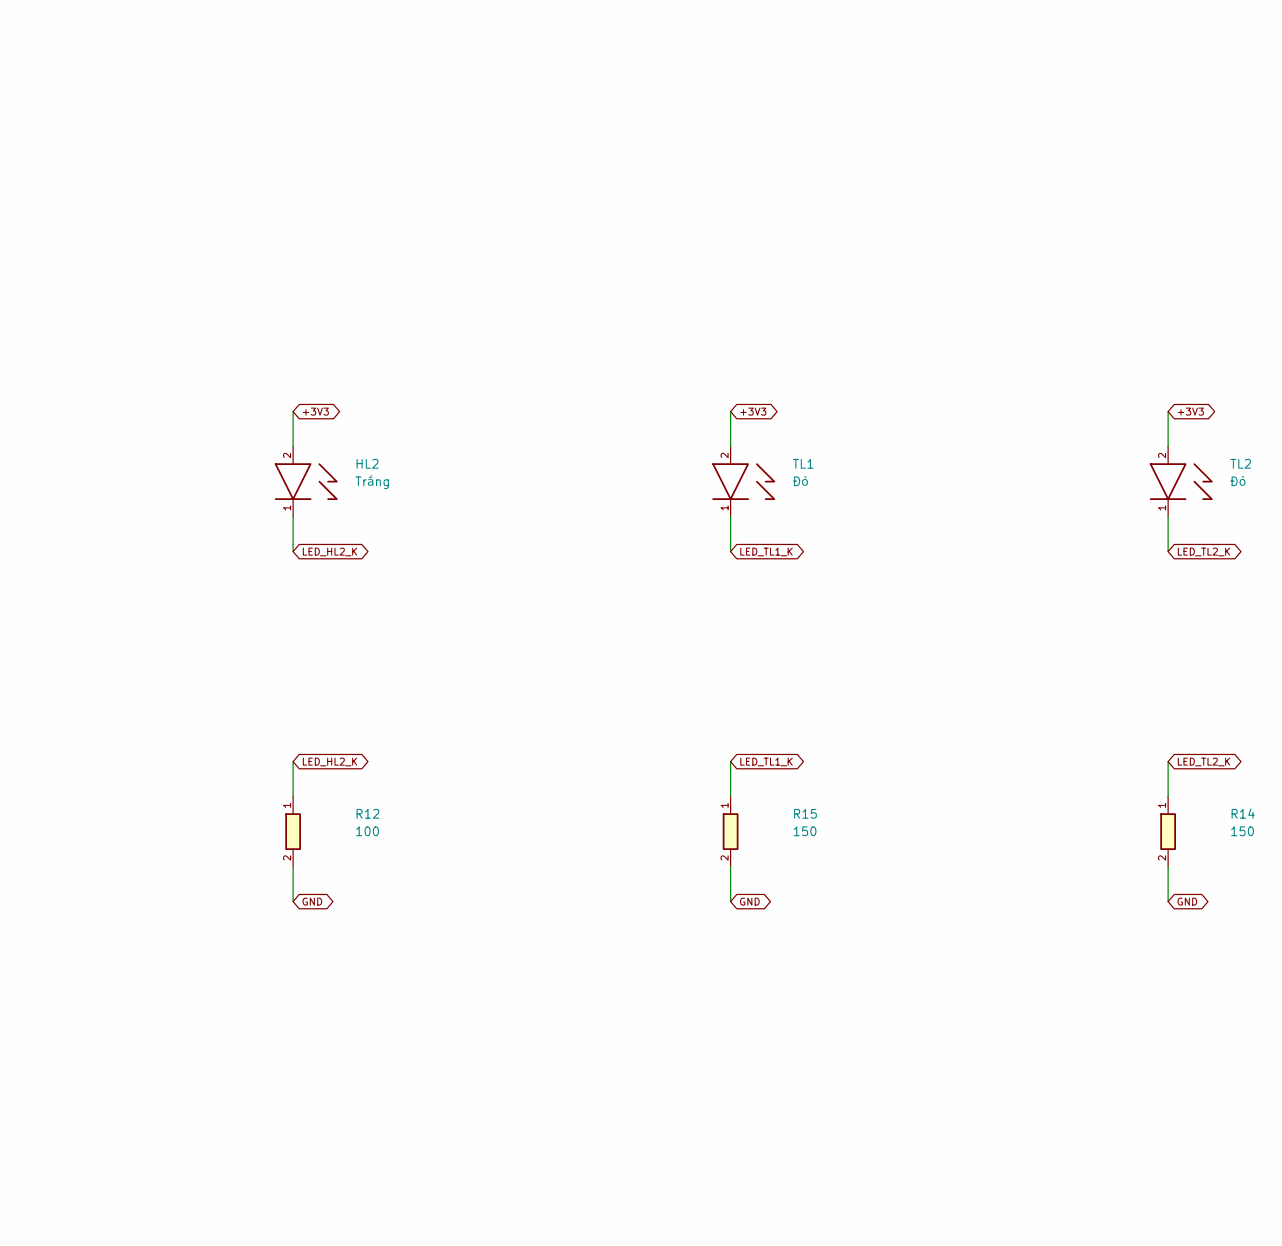
[picture p29: schematic Đèn-LED.kicad_sch, ESP-FLY | Đèn trạng thái và đèn định hướng, part in row 1, column 2]

Parts:
D5: Đỏ; D5; ManufacturerPartNumber TZ-P2-0805RTCS2-0.8T
D6: Xanh lá; D6; ManufacturerPartNumber ORH-G35A
HL1: Trắng; HL1; ManufacturerPartNumber TZ-P2-0805WYCS2-0.8T
HL2: Trắng; HL2; ManufacturerPartNumber TZ-P2-0805WYCS2-0.8T
R10: 200; R10; ManufacturerPartNumber 0805W8F2000T5E
R11: 200; R11; ManufacturerPartNumber 0805W8F2000T5E
R12: 100; R12; ManufacturerPartNumber CRCW0805100RFKEA
R13: 100; R13; ManufacturerPartNumber CRCW0805100RFKEA
R14: 150; R14; ManufacturerPartNumber RMS10FT1500
R15: 150; R15; ManufacturerPartNumber RMS10FT1500
TL1: Đỏ; TL1; ManufacturerPartNumber TZ-P2-0805RTCS2-0.8T
TL2: Đỏ; TL2; ManufacturerPartNumber TZ-P2-0805RTCS2-0.8T

Connections:
+3V3: HL1.2 (A), HL2.2 (A), TL1.2 (A), TL2.2 (A); also elsewhere on the board
GND: R10.2, R11.2, R12.2, R13.2, R14.2, R15.2; also elsewhere on the board
LED_GREEN: D6.2 (A); also elsewhere on the board
LED_GREEN_K: D6.1 (K), R11.1
LED_HL1_K: HL1.1 (K), R13.1
LED_HL2_K: HL2.1 (K), R12.1
LED_RED: D5.2 (A); also elsewhere on the board
LED_RED_K: D5.1 (K), R10.1
LED_TL1_K: R15.1, TL1.1 (K)
LED_TL2_K: R14.1, TL2.1 (K)

Notes on the sheet:
ESP-FLY | Đèn trạng thái và đèn định hướng
Tái dựng từ Gerber Max Imagination, bản 331d8f50 | 4 lớp | dày 1,2 mm
Đèn báo đỏ / xanh: GPIO43 và GPIO9. HL1/HL2: đèn trước màu trắng, 100 Ω. TL1/TL2: đèn sau màu đỏ, 150 Ω. Cả bốn đèn định hướng được cấp nguồn liên tục từ +3V3.

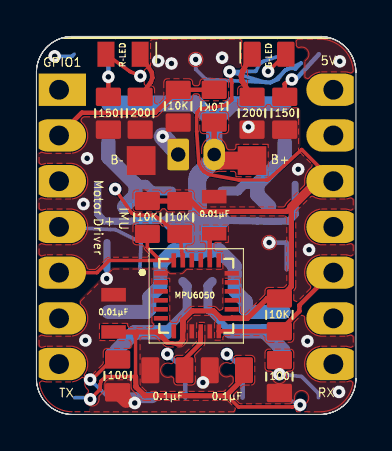
[picture p30: board ESP-FLY.kicad_pcb from above]

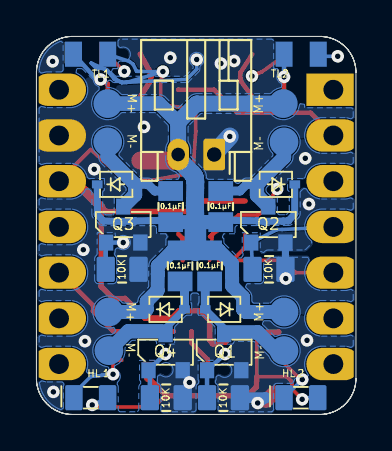
[picture p31: board ESP-FLY.kicad_pcb from below]

Board: 4 copper layers, 17.8 x 21.0 mm, 44 parts (25 on the bottom side), 25 nets.
