Phong28Ng/drone-mini-xiao-esp32s3/firmware/components/drivers/general/motors/include/motors.h

/**
 *
 * ESP-Drone Firmware
 *
 * Copyright 2019-2020  Espressif Systems (Shanghai)
 * Copyright (C) 2011-2012 Bitcraze AB
 *
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
 * Motors.h - Motor driver header file
 *
 */
#ifndef __MOTORS_H__
#define __MOTORS_H__

#include <stdint.h>
#include <stdbool.h>

#include "driver/ledc.h"

#include "config.h"
#include "stm32_legacy.h"


/******** Defines ********/

// CF2 PWM ripple is filtered better at 328kHz. At 168kHz the NCP702 regulator is affected.

#define MOTORS_PWM_BITS           LEDC_TIMER_8_BIT
#define MOTORS_PWM_PERIOD         ((1<<MOTORS_PWM_BITS) - 1)
#define MOTORS_TIM_BEEP_CLK_FREQ  4000000

// Compensate thrust depending on battery voltage so it will produce about the same
// amount of thrust independent of the battery voltage. Based on thrust measurement.

//#define ENABLE_THRUST_BAT_COMPENSATED


#define NBR_OF_MOTORS 4
// Motors IDs define
#define MOTOR_M1  0
#define MOTOR_M2  1
#define MOTOR_M3  2
#define MOTOR_M4  3

#ifdef CONFIG_TARGET_ESPLANE_V2_S2
    #define MOTOR3_GPIO  CONFIG_MOTOR01_PIN         // M1 for ESP32FC
    #define MOTOR4_GPIO  CONFIG_MOTOR02_PIN        // M2 for ESP32FC
    #define MOTOR1_GPIO  CONFIG_MOTOR03_PIN        // M3 for ESP32FC
    #define MOTOR2_GPIO  CONFIG_MOTOR04_PIN        // M4 for ESP32FC
#else
    #define MOTOR1_GPIO  CONFIG_MOTOR01_PIN         // M1 for ESP32FC
    #define MOTOR2_GPIO  CONFIG_MOTOR02_PIN        // M2 for ESP32FC
    #define MOTOR3_GPIO  CONFIG_MOTOR03_PIN        // M3 for ESP32FC
    #define MOTOR4_GPIO  CONFIG_MOTOR04_PIN        // M4 for ESP32FC
#endif

#define MOT_PWM_CH1  4      // Motor M1 pwmchannel
#define MOT_PWM_CH2  5      // Motor M2 pwmchannel
#define MOT_PWM_CH3  6      // Motor M3 pwmchannel
#define MOT_PWM_CH4  7      // Motor M4 pwmchannel     

// Test defines
#define MOTORS_TEST_RATIO         (uint16_t)(0.2*(1<<16))
#define MOTORS_TEST_ON_TIME_MS    200
#define MOTORS_TEST_DELAY_TIME_MS 500

// Sound defines
#define C4    262
#define DES4  277
#define D4    294
#define ES4   311
#define E4    330
#define F4    349
#define GES4  370
#define G4    392
#define AS4   415
#define A4    440
#define B4    466
#define H4    493
#define C5    523
#define DES5  554
#define D5    587
#define ES5   622
#define E5    659
#define F5    698
#define GES5  740
#define G5    783
#define AS5   830
#define A5    880
#define B5    932
#define H5    987
#define C6    1046
#define DES6  1108
#define D6    1174
#define ES6   1244
#define E6    1318
#define F6    1396
#define GES6  1479
#define G6    1567
#define AS6   1661
#define A6    1760
#define B6    1864
#define H6    1975
#define C7    2093
#define DES7  2217
#define D7    2349
#define ES7   2489
#define E7    2637
#define F7    2793
#define GES7  2959
#define G7    3135
#define AS7   3322
#define A7    3520
#define H7    3729
#define B7    3951

// Sound duration defines
#define EIGHTS 125
#define QUAD 250
#define HALF 500
#define FULL 1000
#define STOP 0

typedef enum {
    BRUSHED,
    BRUSHLESS
} motorsDrvType;

typedef struct {
    motorsDrvType drvType;

} MotorPerifDef;

/**
 * Motor mapping configurations
 */
//extern const MotorPerifDef* motorMapNoMotors[NBR_OF_MOTORS];
extern const MotorPerifDef *motorMapDefaultBrushed[NBR_OF_MOTORS];
// extern const MotorPerifDef* motorMapDefaltConBrushless[NBR_OF_MOTORS];
// extern const MotorPerifDef* motorMapBigQuadDeck[NBR_OF_MOTORS];
// extern const MotorPerifDef* motorMapBoltBrushless[NBR_OF_MOTORS];

/**
 * Test sound tones
 */
extern const uint16_t testsound[NBR_OF_MOTORS];
/*** Public interface ***/

bool pwm_timmer_init();
/**
 * Initialisation. Will set all motors ratio to 0%
 */
void motorsInit(const MotorPerifDef **motorMapSelect);

/**
 * DeInitialisation. Reset to default
 */
void motorsDeInit(const MotorPerifDef **motorMapSelect);

/**
 * Test of the motor modules. The test will spin each motor very short in
 * the sequence M1 to M4.
 */
bool motorsTest(void);

/**
 * Set the PWM ratio of the motor 'id'
 */
void motorsSetRatio(uint32_t id, uint16_t ratio);

/**
 * Get the PWM ratio of the motor 'id'. Return -1 if wrong ID.
 */
int motorsGetRatio(uint32_t id);

/**
 * FreeRTOS Task to test the Motors driver
 */
void motorsTestTask(void *params);

/* Set PWM frequency for motor controller
 * This function will set all motors into a "beep"-mode,
 * each of the motor will turned on with a given ratio and frequency.
 * The higher the ratio the higher the given power to the motors.
 * ATTENTION: To much ratio can push your crazyflie into the air and hurt you!
 * Example:
 *     motorsBeep(true, 1000, (uint16_t)(72000000L / frequency)/ 20);
 *     motorsBeep(false, 0, 0); *
 * */
void motorsBeep(int id, bool enable, uint16_t frequency, uint16_t ratio);

#endif /* __MOTORS_H__ */
