Phong28Ng/drone-mini-xiao-esp32s3/(commit log)

2026-11-12 giấy phép GPL-3.0
2026-11-12 code ESP-Drone cho XIAO ESP32-S3 (đã chỉnh chân)
2026-11-12 file mạch: KiCad, Gerber, BOM, sơ đồ nguyên lý
    [BOM.xlsx, C_0805_2012Metric.step, D_SOD-323.step, ESP-FLY-header-1x07-đã-cắt-ngắn.step, ESP-FLY.kicad_pcb, ESP-FLY.kicad_sch, JST_PH_S2B-PH-K_1x02_P2.00mm_Horizontal.step, LED_0805_2012Metric.step]
2026-11-12 thiết kế khung 3D
2026-11-12 sơ đồ khối, lưu đồ, ảnh app và ảnh drone
2026-11-12 giới thiệu dự án
