Phong28Ng/drone-mini-xiao-esp32s3/(notices)

Notices in the files:
hardware/kicad/3dmodels/R_0805_2012Metric.step:
Copyright (C) 2018, kicad StepUp
This work is licensed under the [Creative Commons CC-BY-SA 4.0 License](https://creativecommons.org/licenses/by-sa/4.0/legalcode),
with the following exception:
To the extent that the creation of electronic designs that use 'Licensed Material' can be considered to be 'Adapted Material',
You are free to use the library data in your own projects without the obligation to share your project files under this or any other license agreement.
hardware/kicad/3dmodels/C_0805_2012Metric.step:
Copyright (C) 2017, kicad StepUp
hardware/kicad/3dmodels/JST_PH_S2B-PH-K_1x02_P2.00mm_Horizontal.step:
Copyright (C) 2017, Rene Poeschl
hardware/kicad/3dmodels/QFN-24_4x4mm_P0.5mm.step:
This program is free software: you can redistribute it and/or modify
it under the terms of the GNU General Public License as published by
the Free Software Foundation, either version 3 of the License, or
any later version.
itself might be covered by the GNU General Public License.
hardware/kicad/3dmodels/SOT-23.step:
Copyright (C) 2025, KiCAD
This work is licensed under the
[Creative Commons CC-BY-SA 4.0 License](https://creativecommons.org/licenses/by-sa/4.0/legalcode),
project files under this or any other license agreement. However, if you wish to distribute
